aarochu/DirecSun/docs/firmware-design.md

# DirecSun Flight Firmware: Technical Design and Implementation Plan

**Status:** Design for implementation. No firmware has been written, built, flashed, or run. No hardware has been measured. Imported into the repository on 2026-10-10, when the toolchain changed to ESP-IDF v6.0 with C++17; §23.1 rows V-22 onward record every edit made then.
**Parent document:** *DirecSun Technical Design*, `docs/technical-design.md` (referred to below as **TD**). Section numbers such as "TD §6.5" point into that document.
**Related code:** the wire schema in `protocol/schema-v1.json`, the client side of the protocol in `ground/link/`, and the bench console in `ground/console/`. The main UI is `frontend/` (Aaron's), and the backend matches it (§17).
**Audience:** firmware and software engineers, software architects, agentic architects, and AI agents that will write, review, or change the firmware.

---

## 0. How to use this document

- **Humans** should read §1–§4 for orientation, then the section for the module they own. The diagrams are meant to be read on their own.
- **AI agents** should treat §2 (conventions), §15 (message schema), §13 (mode machine), §14 (interlocks), and §21 (agent rules) as binding contracts. Before changing any number, check §23 (validation log) for whether it has already been disputed.
- Every statement that a reader might act on carries a label (§2.1). An unlabelled sentence is explanation, not a fact to rely on.
- Where this document and TD disagree, §23 records the disagreement, the reasoning, and the resolution chosen here. If a later TD revision resolves it differently, TD wins and this document has a bug.

---

## 1. Purpose, scope, and non-goals

### 1.1 Purpose

Specify the firmware for the Seeed XIAO ESP32-S3 on the DirecSun box. It must:

1. read the inertial, magnetic, optical, wheel-speed, and battery sensors;
2. estimate box heading and rate;
3. run the four-loop control cascade and drive the ESC over DShot;
4. implement the eight operating modes and every safety interlock;
5. serve telemetry and accept commands over a WebSocket on the private Wi-Fi network.

It also gives an ordered implementation plan, a test strategy, and the gates that must pass before the wheel is spun.

### 1.2 Scope

In scope: everything that runs on the XIAO ESP32-S3; the wire protocol it speaks; build and test tooling for that code; the integration contract with the main UI in `frontend/`.

### 1.3 Non-goals

- Multi-axis control, orbit dynamics, flight qualification (TD §1).
- ESC firmware changes. Flashing Bluejay for bidirectional DShot is an open option (TD §12.3), not part of this plan.
- The ground-station page itself, except where its behaviour constrains the firmware (§15, §17).
- Over-the-air firmware update. Firmware is flashed over USB-C (TD §5.5).

---

## 2. Conventions

### 2.1 Claim labels

This document reuses the TD labels and adds one.

| Label | Meaning | What a reader should do |
| --- | --- | --- |
| **[V]** | Verified in TD against an opened source (TD marks it [V]) | Trust it; re-check if the part changes |
| **[C]** | Calculated here or in TD from stated inputs; the arithmetic is shown or reproducible | Re-run if an input changes |
| **[A]** | Assumed, typical, or drawn from the author's knowledge of a library or API that was **not** checked against its documentation while writing this document | Confirm before relying on it; most become build checks |
| **[M]** | Must be measured on the hardware | Measure, record in TD §12.2 |
| **[D]** | Design decision made in this document | Change only with a reason recorded in §23 |

**Important limitation.** While this document was written, no datasheet, library header, or source page was opened. Every hardware fact labelled [V] here inherits its [V] from TD. Every ESP-IDF API fact is labelled [A] and is checked by the build or a bench test listed in §19.

### 2.2 Units and representation

| Quantity | Internal unit (firmware) | Wire unit (JSON) |
| --- | --- | --- |
| Angle | radians, `float` | degrees |
| Angular rate | rad/s | deg/s (`*_dps`) |
| Wheel speed | rpm, `float` | rpm |
| Torque | N·m | mN·m (`*_mNm`) |
| Voltage | V | V |
| Time | microseconds since boot, `int64_t` (`esp_timer_get_time()`) [A] | milliseconds since boot (`t_ms`) |

All control arithmetic uses `float` (the ESP32-S3 has a single-precision FPU) [A]. Accumulated quantities that grow without bound (heading integral, time) use `double` or are wrapped, see §11.3.

### 2.3 Sign and frame conventions (binding)

Taken from TD §4.1 and TD §6.5. They are restated because a sign error makes the rate loop unstable (TD §12.4, R-1).

| Symbol | Definition |
| --- | --- |
| +z | Up the spin axis |
| +X | The sun-sensor face of the box |
| ψ (psi) | Box heading. **Positive counter-clockwise seen from above** |
| ω (omega_b) | Box rate about +z, positive counter-clockwise |
| τ_cmd | Torque wanted **on the box**, positive counter-clockwise |
| Ω | Wheel speed in its **forward** direction. Always positive, between the low limit and the cap. Every limit and interlock applies to Ω |
| s_w | ±1, the sign of the wheel's spin about +z when running forward. Fixed by motor wiring; found in T-5 |

The table above is the firmware's internal frame. The control law, the estimator, and the sign check of §12.5 are written in it.

> **Wire frame (decided 2026-10-10, finding U-1) [D]:** on the wire, every quantity about the spin axis is **clockwise positive seen from above**, matching the main UI in `frontend/`. There, "rotate right" is +90°, and the dial and 3D model turn clockwise for positive values (§17). The quantities are `psi_deg`, `psi_ref_deg`, `mag_deg`, `sun_deg`, `rate_dps`, `tau_cmd_mNm`, the SLEW `psi_ref_deg`, and the MANUAL `rate_dps`. The firmware converts only in its protocol encode and decode: a value x in the internal frame is -x on the wire, in both directions. Nothing else in the firmware knows the wire frame exists. Raw bench sensor counts (`gyro_raw`, `mag_raw`) are not converted. No client converts.

### 2.4 Naming

- Modes on the wire: `SAFE`, `SPINUP`, `READY`, `DETUMBLE`, `HOLD`, `SLEW`, `SUN_POINT`, `MANUAL` [D]. TD's schema examples use `"HOLD"` and `"SLEW"`; the other spellings are fixed here.
- Manual inputs on the wire: `throttle`, `wheel`, `rate` [D].
- Interlock names on the wire: upper snake case, listed in §14.1 [D].
- C++ namespaces follow the module names in §18.

---

## 3. Sources and precedence

1. Measurements recorded in TD §12.2 (none exist yet).
2. TD, including `cad/stack.py` and `docs/sizing.py`, which TD says win over TD's prose.
3. This document.
4. Ground code: the main UI in `frontend/`, and the bench tools `ground/link/` and `ground/console/`. They must follow 1 to 3 for anything about the device, and `protocol/schema-v1.json` must agree with §15.

For the wire interface (message fields, units, sign, endpoint), the main UI leads: the schema encodes what `frontend/` expects, and §15 and the firmware follow (owner decision 2026-10-10, finding U-3).

---

## 4. System context

### 4.1 Context diagram

```mermaid
flowchart LR
    subgraph BOX["DirecSun box (rotates on two 608 bearings)"]
        direction TB
        PACK["8 x AA NiMH pack<br/>8.8 to 11.2 V"] --> FUSE["10 A fuse"]
        FUSE --> ESC["BLHeli_S ESC"]
        FUSE --> BUCK["5 V buck"]
        FUSE --> DIV["100k / 22k divider"]
        BUCK --> XIAO["XIAO ESP32-S3<br/>(this firmware)"]
        BUCK --> HALL["A1104 Hall switch"]
        XIAO -- "3V3 + I2C 400 kHz" --> IMU["MPU-6050"]
        IMU -- "STEMMA QT" --> MAG["QMC5883P"]
        MAG -- "STEMMA QT" --> BMP["BMP280"]
        SUN["OP550 x 2"] -- "ADC1 D0, D1" --> XIAO
        DIV -- "ADC1 D9" --> XIAO
        HALL -- "D10 falling edge" --> XIAO
        XIAO -- "DShot on D8 (RMT)" --> ESC
        ESC -- "3 phases" --> MOTOR["2212 motor + washer flywheel"]
        MOTOR -. "magnets pass sensor" .-> HALL
    end
    XIAO <-- "Wi-Fi, WebSocket JSON v1" --> AP["Wi-Fi access point, 2.4 GHz<br/>(OM5P-AC, hotspot, or venue)"]
    AP <--> LAPTOP["Laptop browser<br/>ground station"]
```

### 4.2 External interfaces of the firmware

| Interface | Peer | Direction | Defined in |
| --- | --- | --- | --- |
| I2C bus, 400 kHz | MPU-6050 0x68, QMC5883P 0x2C, BMP280 0x77 | read/write | TD §5.3 [V]; §10 |
| ADC1 ch0, ch1 (GPIO1, GPIO2) | OP550 A, B | read | TD §5.4 [V] |
| ADC1 ch7 (GPIO8) | Battery divider | read | TD §5.4 [V] |
| GPIO9 interrupt | A1104 | input | TD §5.4 [V] |
| GPIO7 RMT TX | ESC DShot input | output | TD §5.4 [V] |
| Wi-Fi STA, WebSocket server on port 80 at `/ws` | Main UI (`frontend/`), bench console | bidirectional | TD §7 [V]; §15 |
| USB-C serial | Developer | log output, flashing | TD §5.5 |
| NVS | Flash | parameter storage | TD §6.1 [D in TD] |

GPIO numbering follows the XIAO pin table in TD §5.4: D0 = GPIO1, D1 = GPIO2, D4 = GPIO5 (SDA), D5 = GPIO6 (SCL), D8 = GPIO7, D9 = GPIO8, D10 = GPIO9 [V]. GPIO1 to GPIO10 are ADC1 channels 0 to 9 [V], so GPIO8 is ADC1 channel 7 [C].

---

## 5. Requirements traced to firmware mechanisms

| ID (TD §2) | Requirement | Firmware mechanism | Verified by |
| --- | --- | --- | --- |
| FR-1 | Reaction wheel is the only actuator | Single DShot output; no other actuator code path | Review |
| FR-2 | Eight modes, mode change within 100 ms | Mode machine (§13) runs every 2 ms tick; command queue drained every tick, so a valid command takes effect within one tick plus network latency | T-13, host test HT-7 |
| FR-3 | 50 Hz telemetry, < 100 ms latency | Snapshot every 10th control tick; comms task sends without blocking control (§7.4) | T-11 |
| FR-4 | Untethered | Battery monitor, Wi-Fi only | Review |
| FR-5 | Safe stop | E-stop command, 1 s heartbeat timeout, undervoltage, plus the full interlock table (§14) | T-13 |
| PR-1 | Detumble 1 rev/s to < 5 deg/s in 5 s | `DETUMBLE` mode, rate loop with ω_cmd = 0 | T-15 |
| PR-2 | 90 deg slew in 3 s, ±3 deg | `SLEW` trapezoid 60 deg/s, 120 deg/s² (about 2.0 s of profile) [C] | T-16 |
| PR-3 | Hold ±2 deg | `HOLD`, attitude + rate loop with integral and anti-windup | T-17 |
| PR-4 | Wheel energy < 6 J at cap, < 6.5 J worst case | Ω_ref clamped to the 4000 rpm cap; overspeed trip at 4100 rpm (5.99 J) [C] | Host test HT-5, T-13 |

The PR-1 requirement needs the gyro range to cover at least 360 deg/s, and TD §10.1 says the box can reach about 4.0 rev/s (1440 deg/s) if the wheel stops from the cap [C]. The gyro is therefore configured for ±2000 deg/s (§10.1, finding V-9).

---

## 6. Hardware interface summary for firmware authors

| Item | Value | Label |
| --- | --- | --- |
| MCU | ESP32-S3, dual core | [V] TD §6.1 |
| Framework | ESP-IDF v6.0, C++17 application code, FreeRTOS tasks | [D] 2026-10-10 (TD §6.1; V-22 records the earlier choice) |
| I2C | SDA GPIO5, SCL GPIO6 on port 0, owned by esp-idf-lib `i2cdev`; every device at 400 kHz, fallback 100 kHz. The library defaults (1 MHz for the esp-idf-lib drivers, 100 kHz hard-coded in the QMC5883P driver) are overridden | [V] TD §5.3 to 5.4 for pins and rate; [V] defaults read from the driver source, 2026-10-10 |
| DShot | DShot300 if ESC MCU is 48 MHz ("H" in its name), DShot150 if 24 MHz ("L") | [V] TD §5.2; [M] read in ESC Configurator |
| DShot frame | 11-bit throttle, 1 telemetry bit, 4-bit CRC; 0 = disarm, 1–47 commands, 48–2047 throttle | [V] TD §6.3 |
| Hall | 2 magnets, both south-out → 2 falling edges per wheel turn | [V] TD §4.6 |
| Battery divider | 22/122 = 0.1803; 11.2 V → 2.02 V; 8.8 V → 1.59 V; 9.6 V → 1.73 V | [C] |
| ADC | 12 dB attenuation, usable to about 2.9 V | [V] TD §5.1 |
| Sensors' supply | 3.3 V from XIAO 3V3 | [V] TD §5.3 |

Derived wheel timing (two Hall edges per turn) [C]:

| Wheel speed | Mechanical | Hall edges/s | Edge period | Motor electrical frequency (7 pole pairs, [A] A-6) | Stored energy |
| --- | --- | --- | --- | --- | --- |
| 800 rpm (low limit, [A] A-8) | 13.3 Hz | 26.7 | 37.5 ms | 93 Hz | 0.23 J |
| 2400 rpm (bias) | 40.0 Hz | 80.0 | 12.5 ms | 280 Hz | 2.05 J |
| 4000 rpm (cap) | 66.7 Hz | 133.3 | 7.5 ms | 467 Hz | 5.70 J |
| 4100 rpm (trip) | 68.3 Hz | 136.7 | 7.3 ms | 478 Hz | 5.99 J |

---

## 7. Software architecture

### 7.1 Principles

1. **One authority per fact.** The control task owns all state. Every other context gets copies.
2. **Control never waits on the network.** Communication between cores uses lock-free or very short critical sections; nothing on the control path blocks on Wi-Fi, TCP, JSON, or flash.
3. **Pure core, thin drivers.** Estimation, control, mode logic, interlocks, DShot encoding, and message parsing are pure functions or plain classes with no hardware calls, so they compile and run on a desktop (§19.1).
4. **Fail to zero throttle.** Every fault path ends in DShot 0 (TD §6), either immediately or after the e-stop ramp (§14.3).
5. **The box is the authority on mode** (TD §7.3). The ground never assumes a command succeeded.

### 7.2 Tasks and cores

| Context | Core | Priority (FreeRTOS) | Period | Work | Label |
| --- | --- | --- | --- | --- | --- |
| `control` task | 1 | Highest application priority (e.g. `configMAX_PRIORITIES − 2`) | 2 ms (500 Hz) | Sensor reads, estimator, mode machine, controllers, interlocks, DShot frame, telemetry snapshot | [D]; rate [V] TD §6.2 |
| Tick source | n/a | ISR | 2 ms | `gptimer` alarm ISR gives a task notification to `control` | [D]; API [A] |
| Hall ISR | any (registered from core 1) | ISR, IRAM | per edge | Store `esp_timer_get_time()` in a ring buffer | [D]; API [A] |
| `comms` task | 0 | Above the main task, below the Wi-Fi driver | event-driven + 50 Hz | WebSocket server, JSON encode/decode, ping/pong, client management | [D] |
| Wi-Fi/lwIP | 0 | System | n/a | Provided by ESP-IDF | [A] default core 0 |
| `app_main` | 0 | Default main-task priority | once | Runs the boot sequence (§8), creates the tasks, returns | [D] |
| Task watchdog | system | n/a | 100 ms | Resets the MCU if `control` stops feeding it | [V] TD §6.2 for the 100 ms |

Why a hardware timer instead of `vTaskDelayUntil(2)`: the project runs FreeRTOS at a 1 kHz tick (`CONFIG_FREERTOS_HZ=1000` in `firmware/sdkconfig.defaults`), so `vTaskDelayUntil` could produce a 2 ms period, but its jitter is a full tick. A `gptimer` alarm gives sub-tick jitter [A]. Either works; the timer is the default and `vTaskDelayUntil` is the fallback if the timer API does not build (build check BC-3, §19.3).

### 7.3 Module and data-flow diagram

```mermaid
flowchart TB
    subgraph CORE1["Core 1: control task, 500 Hz"]
        direction TB
        TICK["gptimer ISR<br/>notify every 2 ms"] --> SENSE
        HALLISR["Hall ISR<br/>edge timestamps"] --> SENSE
        SENSE["Drivers: IMU (every tick)<br/>MAG (every 2nd tick)<br/>ADC sun, battery (every 10th)"] --> EST["Estimator<br/>rate, heading, sun angle, wheel speed"]
        EST --> MODE["Mode machine"]
        CMDQ["Command queue<br/>(single producer)"] --> MODE
        MODE --> CTRL["Control cascade<br/>attitude, rate, torque-to-wheel, wheel PI"]
        EST --> CTRL
        CTRL --> SAFE["Interlocks<br/>(may override everything)"]
        EST --> SAFE
        SAFE --> DSHOT["DShot encoder + RMT TX"]
        SAFE --> SNAP["Telemetry snapshot<br/>(every 10th tick)"]
    end
    subgraph CORE0["Core 0: comms task"]
        direction TB
        WS["WebSocket server"] --> PARSE["JSON parse + validate"]
        PARSE --> CMDQ
        SNAP --> ENC["JSON encode tlm, event, ack"]
        ENC --> WS
    end
    DSHOT --> ESCX["ESC"]
    WS <--> NET["Wi-Fi"]
```

### 7.4 Shared state and concurrency

| Channel | Producer → consumer | Mechanism | Rule |
| --- | --- | --- | --- |
| Commands | comms → control | FreeRTOS queue, depth 16, items are a fixed-size `Command` struct; `xQueueSend` with timeout 0 from comms, `xQueueReceive` with timeout 0 in control | Full queue: comms answers `ack ok:false reason:"busy"`. `estop` bypasses the queue through an atomic flag (below) |
| E-stop | comms → control | `std::atomic<bool> estop_requested` | Set by comms on any `estop`; read and cleared by control on the next tick |
| Heartbeat | comms → control | `std::atomic<int64_t> last_heartbeat_us` | Written on every accepted `ping` or `cmd` from the controlling client |
| Telemetry snapshot | control → comms | Double buffer + sequence counter (seqlock) | Control writes the inactive buffer, then flips an atomic index. Comms copies the active buffer and retries if the counter changed during the copy. Control never waits |
| Events and acks | control → comms | FreeRTOS queue, depth 16 | Control posts with timeout 0; if full, the event is dropped and a `dropped_events` counter in telemetry increments |
| Hall edges | ISR → control | Ring buffer of 8 `int64_t` timestamps + atomic write index | ISR writes only; control reads only |

TD §6.2 specifies "a snapshot struct copied under a spinlock". The seqlock above gives the same consistency without control ever spinning on a lock held by core 0 [D, finding V-12]. A `portMUX` spinlock around a ~200-byte `memcpy` is an acceptable simpler alternative, since the copy takes microseconds [A].

---

## 8. Boot and initialization

### 8.1 Sequence

```mermaid
flowchart TD
    A["Power on or reset"] --> B["Configure GPIO7 as RMT TX,<br/>start sending DShot 0 every 2 ms"]
    B --> C["Init serial log, NVS,<br/>load parameters with defaults and range checks"]
    C --> D["I2C init 400 kHz, bus recovery pulses"]
    D --> E{"MPU-6050 WHO_AM_I == 0x68?"}
    E -- no --> F["Fault: IMU_MISSING<br/>stay in SAFE, keep DShot 0,<br/>report over Wi-Fi when up"]
    E -- yes --> G["Configure MPU-6050:<br/>wake, DLPF_CFG=4, gyro ±2000 dps, accel ±4 g"]
    G --> H{"QMC5883P chip ID 0x00 == 0x80?"}
    H -- no --> I["Fault: MAG_MISSING<br/>SAFE; HOLD, SLEW, SUN_POINT refused"]
    H -- yes --> J["Configure QMC5883P continuous 200 Hz"]
    I --> K
    J --> K["BMP280 probe 0x77 then 0x76<br/>(optional, never blocks boot)"]
    K --> L["ADC1 init + calibration scheme"]
    L --> M["Attach Hall ISR on GPIO9, falling edge"]
    M --> N{"At least 1 s of DShot 0 sent?"}
    N -- no --> N
    N -- yes --> O["Start control task on core 1<br/>mode = SAFE"]
    O --> P["Start Wi-Fi STA: DHCP, mDNS direcsun.local<br/>(static IP or SoftAP if configured)<br/>start comms task on core 0"]
    P --> Q["Enable 100 ms task watchdog on control"]
    F --> P
```

### 8.2 Notes and rationale

- **DShot 0 starts first.** The ESC arms only after seeing zero throttle [V] TD §5.2, and TD §6.3 asks for about 1 s of zeros [A] A-22. Sending zeros from the first milliseconds also means that a reset caused by the watchdog stops drive quickly. The ESC itself switches drive off about 0.3 s after pulses stop [V] TD §5.2, so the reset gap is bounded either way.
- **Boot does not wait for Wi-Fi.** The box is safe in `SAFE` without a ground connection; heartbeat rules only apply in active modes (§14.1).
- **Missing magnetometer** is not fatal: `DETUMBLE` needs only the gyro. Modes that need heading (`HOLD`, `SLEW`, `SUN_POINT`) are refused with a reason [D].
- **Gyro bias.** Bias is estimated continuously while the box is in `SAFE` **and** still (§11.1). It is not taken once at boot, because the box may be moving after a watchdog reset [D, finding V-10].

---

## 9. The control tick

### 9.1 Per-tick flow (every 2 ms)

```mermaid
flowchart TD
    T0["Task notified by timer"] --> T1["t = esp_timer_get_time()<br/>record loop start"]
    T1 --> T2["Read MPU-6050 14 bytes from 0x3B<br/>(accel, temp, gyro)"]
    T2 --> T3{"Even tick?"}
    T3 -- yes --> T4["Read QMC5883P status; if DRDY,<br/>read 6 data bytes, add to 20 ms average"]
    T3 -- no --> T5
    T4 --> T5{"Every 10th tick?"}
    T5 -- yes --> T6["Read sun A, sun B, battery ADC<br/>(spread over ticks 0, 3, 6 of each 10)"]
    T5 -- no --> T7
    T6 --> T7["Drain Hall ring buffer;<br/>update wheel speed estimate"]
    T7 --> T8["Estimator update:<br/>rate, heading (mag fused at 50 Hz), sun angle"]
    T8 --> T9["Drain command queue;<br/>check e-stop flag"]
    T9 --> T10["Mode machine step<br/>(guards, transitions, setpoints)"]
    T10 --> T11["Control cascade → throttle request"]
    T11 --> T12["Interlock evaluation<br/>(may force ramp-down or DShot 0)"]
    T12 --> T13["Encode DShot frame, start RMT transmit<br/>(non-blocking)"]
    T13 --> T14{"Every 10th tick?"}
    T14 -- yes --> T15["Write telemetry snapshot"]
    T14 -- no --> T16
    T15 --> T16["loop_us = now − start;<br/>feed watchdog; wait for next notify"]
```

### 9.2 Timing budget (target, to be measured as `loop_us`)

| Step | Estimate | Label |
| --- | --- | --- |
| IMU burst read, 14 bytes at 400 kHz | 0.39 ms (155 bit times) | [C] |
| Magnetometer status + 6 bytes (every 2nd tick) | about 0.25 ms | [C] |
| One ADC read with calibration (at most one per tick) | tens of µs | [A] |
| Estimator + controllers + interlocks (float) | < 50 µs | [A] |
| DShot encode + RMT start | < 20 µs; the 53 µs DShot300 frame is sent by hardware | [A]; frame [V] |
| JSON is **not** on this core | 0 | [D] |
| **Worst tick** | **about 0.75 ms of 2 ms** | [C on A] |

At 100 kHz I2C the IMU read alone is 1.55 ms [C], and an IMU + magnetometer tick would exceed 2 ms, which is why TD §5.3 runs the bus at 400 kHz. Every tick reads the IMU, so there is no tick free for the magnetometer at 100 kHz. If the oscilloscope check in TD §5.3 forces 100 kHz, the control rate falls to 250 Hz (4 ms ticks: IMU 1.55 ms, plus magnetometer status and data on alternate ticks, about 0.8 ms), and the gains in §12.2 are rechecked for the longer step [D, finding V-6].

`loop_us` above 1500 for more than 10 consecutive ticks raises a `LOOP_OVERRUN` warning flag. A tick that is still running when the next notification arrives counts as a missed tick; 25 consecutive missed ticks (50 ms) trip `CONTROL_STALL` before the watchdog fires [D].

---

## 10. Drivers

### 10.1 MPU-6050 (I2C 0x68)

| Register | Address | Value | Why | Label |
| --- | --- | --- | --- | --- |
| PWR_MGMT_1 | 0x6B | 0x01 (wake, PLL with X gyro clock) | Leaves sleep; gyro clock is more stable than the internal oscillator | [A] register map; TD cites the map as [V] |
| SMPLRT_DIV | 0x19 | 0 | 1 kHz output with DLPF enabled | [A] |
| CONFIG | 0x1A | DLPF_CFG = 4 | 20 Hz gyro / 21 Hz accel bandwidth, 8.3 ms gyro delay | [V] TD §6.4 |
| GYRO_CONFIG | 0x1B | FS_SEL = 3 (±2000 deg/s, 16.4 LSB per deg/s) | Box can reach about 1440 deg/s after a stop from the cap | [C] range need; [A] scale |
| ACCEL_CONFIG | 0x1C | AFS_SEL = 1 (±4 g, 8192 LSB/g) | Headroom for imbalance vibration (T-7 target 0.05 g RMS) without clipping on taps | [D]; [A] scale |
| Data | 0x3B..0x48 | 14-byte burst: accel XYZ, temperature, gyro XYZ, big-endian | One transaction per tick | [A] |
| WHO_AM_I | 0x75 | expect 0x68 | Boot check (TD §6.6) | [A] value; TD names the check |

Driver: esp-idf-lib `mpu6050` ^2.1.9 on `i2cdev`, validated alone on the S3 by the owner. Its device clock is set to 400 kHz before the first transaction, overriding the library's 1 MHz default [D]. Whether `mpu6050_get_motion()` issues the single 14-byte burst §9.2 assumes is [A]; if it does not, the driver wrapper reads 0x3B to 0x48 with one register read.

Error handling: an I2C error or a timeout of more than 1 ms marks the sample invalid. 25 consecutive invalid samples (50 ms) trip `IMU_SILENT` [V] TD §6.7 threshold. After three consecutive errors the driver runs bus recovery (nine SCL clock pulses, then STOP) once [A] standard I2C practice.

Axis mapping: the board sits face up, centred on the spin axis (TD §4.8), so sensor +Z is taken as box +z [A]. T-8 confirms by rotating the box counter-clockwise by hand and checking that ω reads positive [M].

### 10.2 QMC5883P (I2C 0x2C)

| Item | Value | Label |
| --- | --- | --- |
| Chip ID | register 0x00 reads 0x80 | [V] TD §5.3 |
| Data | 0x01..0x06, X/Y/Z | [V] TD §5.3; byte order [A], confirm in the QST datasheet |
| Status | 0x09, data-ready bit | [V] register; bit position [A] |
| Control | 0x0A, 0x0B: continuous mode, output data rate 200 Hz, oversampling and range | [V] registers; **bit values [A]: read them from the QST datasheet before writing the driver** |

Driver: the vendored `duruofu/qmc5883p` 0.1.0 in `firmware/components/qmc5883p`, given the i2cdev bus through `i2cdev_get_shared_handle(I2C_NUM_0, ...)` after the first i2cdev transaction has created it [D]. The driver hard-codes a 100 kHz device clock, and its own comments flag its 8 G sensitivity value as uncertain; both are corrected by documented local patches after checking the QST datasheet [A].

Sampling plan (revised from TD, finding V-5): the control loop runs at 500 Hz and the magnetometer at 200 Hz, so 200 Hz is not an integer divisor of the tick rate. The driver polls the status register every 2nd tick (250 Hz). It reads data only when data-ready is set, which yields every new 200 Hz sample once, and averages all new samples in each 20 ms window into one 50 Hz heading measurement [D].

Mounting: the board hangs upside down under the flipped top deck (TD §4.8). Turning a board over is a 180° rotation about a horizontal axis, which flips **Z and one horizontal axis**, not Z alone (finding V-4). Heading uses only the horizontal components, so the horizontal flip matters and the Z flip does not. The driver applies a configurable axis map `mag_axis_map` (default: negate Y and Z, keep X), and T-9 confirms it: rotating the box counter-clockwise must make magnetic heading increase in the same direction as the integrated gyro [M].

### 10.3 BMP280 (I2C 0x77, optional)

Probed at boot at 0x77, then 0x76 [V] TD §5.3. It is read at 1 Hz on a spare tick if present, and reported in telemetry as `t_c` and `p_pa` (§15.3). It never affects control, modes, or boot [V] TD §5.3. If absent, the fields are `null`. Driver: esp-idf-lib `bmp280` ^1.0.7 at 400 kHz.

### 10.4 A1104 Hall sensor and wheel speed

```mermaid
flowchart LR
    E["Falling edge on GPIO9"] --> I["ISR (IRAM):<br/>t = esp_timer_get_time()<br/>ring[w mod 8] = t; w = w + 1"]
    I --> C["Control tick reads new edges"]
    C --> P["Period = t_k − t_(k−1)"]
    P --> R{"Period plausible?<br/>3 ms ≤ p ≤ 200 ms"}
    R -- no --> X["Discard; count glitch"]
    R -- yes --> S["speed_fast = 30 / p (rpm)<br/>speed_safe = median of last 4"]
    S --> ST{"Time since last edge<br/>> 2 × last period?"}
    ST -- yes --> U["Speed upper bound = 30 / elapsed;<br/>use the lower of bound and estimate"]
    ST -- no --> OK["Fresh estimate"]
```

| Item | Value | Label |
| --- | --- | --- |
| Edges per turn | 2 | [V] TD §4.6 |
| Speed from period p (seconds) | Ω = 60 / (2p) = 30 / p rpm | [C] |
| Plausibility window | 3 ms (10,000 rpm) to 200 ms (150 rpm) | [D] |
| Control estimate `speed_fast` | Latest single period | [D], finding V-7 |
| Interlock estimate `speed_safe` | Median of the last 4 periods | [V] TD §6.4 |
| Staleness rule | If no edge for more than 2 × the last period, the true speed is below 30 / elapsed, so the estimate is replaced by that bound | [C] |
| Pull-up | 12 kΩ to 3.3 V, external | [V] TD §5.3; internal pull-up also enabled [D] |

**Why two estimates (finding V-7).** The median of 4 periods spans 50 ms at bias and delays the estimate by roughly 25 ms [C]. In a speed loop aimed at 5 Hz, a 25 ms delay costs about 45° of phase [C], too much for a margin-limited loop. The control loop therefore uses the latest period, and the interlocks use the median, which rejects single bad edges.

### 10.5 ADC: sun sensors and battery

| Channel | GPIO | Rate | Processing | Label |
| --- | --- | --- | --- | --- |
| Sun A | 1 (ADC1 ch0) | 50 Hz | Calibrated mV, 4-sample average | [V] pin; [D] averaging |
| Sun B | 2 (ADC1 ch1) | 50 Hz | Same | n/a |
| Battery | 8 (ADC1 ch7) | 50 Hz | mV / 0.1803, then a 1 s moving average for the undervoltage interlock | [C] ratio |

Use the ESP-IDF `adc_oneshot` driver with `ADC_ATTEN_DB_12` and the `adc_cali` curve-fitting scheme for mV conversion [A]. ADC2 must not be used, because it is unavailable with Wi-Fi on [V] TD §5.4.

### 10.6 DShot output

```mermaid
flowchart LR
    TH["Throttle request 0..2047<br/>(0 = stop, 48..2047 = throttle)"] --> V["v = (throttle shifted left 1) OR telemetry bit 0"]
    V --> CRC["crc = (v XOR v shr 4 XOR v shr 8) AND 0xF"]
    CRC --> F["frame = (v shifted left 4) OR crc<br/>16 bits, MSB first"]
    F --> RMT["RMT bytes encoder:<br/>bit1 = high 75 percent, bit0 = high 37.5 percent"]
    RMT --> PIN["GPIO7"]
```

| Item | DShot300 | DShot150 | Label |
| --- | --- | --- | --- |
| Bit period | 3.333 µs | 6.667 µs | [C] |
| Frame (16 bits) | 53.3 µs | 106.7 µs | [C]; DShot300 value [V] TD §6.2 |
| '1' high time (75 %) | 2.50 µs | 5.00 µs | [A] Betaflight convention |
| '0' high time (37.5 %) | 1.25 µs | 2.50 µs | [A] |
| RMT ticks at 40 MHz resolution | bit 133, '1' 100 high + 33 low, '0' 50 high + 83 low | ×2 | [C] |

Implementation choice [D]: use the ESP-IDF 5.x RMT TX channel with the built-in **bytes encoder** (configurable `bit0`/`bit1` symbols, MSB first) on the 2-byte frame [A]. This avoids a custom encoder and any external DShot library (TD A-18). If the bytes encoder is unavailable, write the 16-symbol encoder TD §6.1 describes.

Test vectors for the host test HT-1 [C, computed]:

| Throttle | Telemetry bit | 12-bit value | CRC | 16-bit frame |
| --- | --- | --- | --- | --- |
| 0 | 0 | 0x000 | 0x0 | `0x0000` |
| 48 | 0 | 0x060 | 0x6 | `0x0606` |
| 1046 | 0 | 0x82C | 0x6 | `0x82C6` |
| 2047 | 0 | 0xFFE | 0xE | `0xFFEE` |

Rules [D]:

- Commands 1–47 (beeps, direction, settings) are **never** sent by flight code. ESC settings, including **Brake on stop = off** (TD §5.2, §10.3), are made in ESC Configurator.
- Throttle values 1–47 from the controller are mapped to 0. The minimum running throttle is the value that holds the low-limit speed, from the T-5/T-18 map.
- One frame per 2 ms tick. That is within BLHeli_S limits [V] TD §6.2. Frames are never skipped, because a gap longer than about 0.3 s stops the motor [V] TD §5.2.

---

## 11. Estimation

### 11.1 Box rate

```
ω̂ = s_gyro · (g_z − b_z)        [rad/s]
```

- `s_gyro` = +1 by default, confirmed in T-8 [M].
- **Bias `b_z`:** updated with a slow exponential average (time constant 5 s) only when all of these hold: mode is `SAFE`, |g_z − b_z| < 2 deg/s, accel magnitude within 0.05 g of 1 g, and the wheel is below 200 rpm or the box is held [D]. The update is frozen otherwise, so a spinning box after an e-stop cannot corrupt the bias (finding V-10).
- **Vibration:** the 20 Hz DLPF passes 25 to 45 % of the 40 Hz bias-speed vibration [V] TD §6.4. A software notch filter is implemented but off by default. When enabled, its centre follows `speed_safe / 60` Hz and it is switched on only if T-7/T-8 show residual vibration in ω̂ [D].

### 11.2 Wheel speed

See §10.4. `Ω̂ = speed_fast` for control, `speed_safe` for interlocks and telemetry.

### 11.3 Heading

Complementary filter (TD §6.4):

```
every tick (Δt = 2 ms):        ψ̂ ← ψ̂ + ω̂ Δt
every 50 Hz magnetometer step:  ψ̂ ← ψ̂ + k · wrap(ψ_mag − ψ̂),   k = Δt_mag / τ = 0.02 s / 2 s = 0.01
```

| Item | Value | Label |
| --- | --- | --- |
| τ | 2 s, tunable in T-9 | [A] TD §6.4 |
| k per 20 ms step | 0.01 | [C] |
| ψ_mag | `atan2` of the calibrated horizontal field, with a sign chosen so that a counter-clockwise turn increases it (axis map, §10.2) | [M] T-9 |
| Calibration | Hard-iron offset (3 values) + soft-iron 2×2 matrix in the horizontal plane, from a 360° rotation; stored in NVS | [A] method; [M] values |
| `wrap()` | maps to (−π, π] | [D] |
| Storage | ψ̂ kept continuous (unwrapped) as `double` for control; wrapped only for display | [D] |
| Reported | `psi_deg` = wrapped ψ̂ in (−180, 180]; `mag_deg` = wrapped ψ_mag | [D] |
| `zero_heading` command | Adds an offset so that ψ̂ reads 0 at the current orientation; offset stored in RAM, not NVS | [D] |

**Aliasing (finding V-5).** TD §6.4 says the motor's magnets rotate at 13 to 67 Hz and that 200 Hz sampling avoids aliasing. The mechanical rotation is 13 to 67 Hz, but a 14-pole rotor and the phase currents produce fields at the electrical frequency, 7 × mechanical = 93 to 467 Hz [C on A-6]. That is above the 100 Hz Nyquist limit of 200 Hz sampling, so components there **can** alias. The firmware still samples at 200 Hz and averages, which attenuates some of it, but the real defences are the 14 cm distance, the QMC5883P's own oversampling filter, the gyro-dominant filter (τ = 2 s), and T-9 at three wheel speeds. If T-9 shows a speed-dependent offset, the fallback is a per-speed heading correction table indexed by Ω̂ [D].

### 11.4 Sun angle

```
d = (A − B) / (A + B)          valid only when A + B > light_threshold
sun_rad = calibration(d)       piecewise-linear table from T-10
```

`sun_valid` is false below the threshold or outside the calibrated range [V] TD §6.4. `SUN_POINT` drops to `READY` after 0.5 s of invalid sun angle [D].

### 11.5 Tilt

Tilt angle = `acos(a_z / |a|)` from the averaged accelerometer (20 ms window). Interlock above 30° [V] TD §6.7. It is evaluated on the averaged vector, so a single vibration spike does not trip it [D].

---

## 12. Control law

### 12.1 Cascade

```mermaid
flowchart LR
    REF["ψ_ref<br/>(Hold capture,<br/>Slew trapezoid)"] --> A["Attitude P<br/>ω_cmd = K_ψ · wrap(ψ_ref − ψ̂)<br/>limit ±90 deg/s"]
    A --> R["Rate PI<br/>τ_cmd = K_ω e + K_i ∫e<br/>limit ±31 mN·m"]
    R --> W["Torque → wheel reference<br/>Ω_ref += −s_w τ_cmd (1/I_w + 1/I_b) Δt<br/>clamp [Ω_low, Ω_cap]"]
    W --> S["Wheel speed PI + feed-forward<br/>throttle = FF(Ω_ref) + PI(Ω_ref − Ω̂)"]
    S --> D["DShot throttle"]
    D --> P(("Plant"))
    P -- "ψ̂ (gyro + mag)" --> A
    P -- "ω̂ (gyro)" --> R
    P -- "Ω̂ (Hall)" --> S
```

`DETUMBLE` bypasses the attitude block (ω_cmd = 0). `READY` also uses ω_cmd = 0 [V] TD §6.6. `SUN_POINT` replaces `wrap(ψ_ref − ψ̂)` with the calibrated sun angle [V] TD §6.5.

### 12.2 Starting gains and limits

All gains are starting points until G2 (plant measured) [V] TD §6.5. Values recomputed here with the current TD plant (I_b = 1.03e-3 kg·m², I_w = 6.50e-5 kg·m²):

| Parameter | Value | Derivation | Label |
| --- | --- | --- | --- |
| K_ψ | 3.1 s⁻¹ | about 0.49 Hz attitude bandwidth (3.1 / 2π) | [C] TD §6.5 |
| ω_cmd limit | ±90 deg/s | TD §6.5 | [V] TD |
| K_ω | **0.0129 N·m·s/rad** | 2π · 2 Hz · I_b with I_b = 1.03e-3. TD §6.5 states 0.011, which equals 2π · 2 · 8.9e-4, the superseded I_b (finding V-1) | [C] |
| K_i (rate) | start at K_ω · 2π · 0.2 Hz = 0.0163 N·m/rad | Integral corner a decade below the 2 Hz rate bandwidth [D] | [C on D] |
| Integral limit | ±3 mN·m equivalent | Covers the planned friction range 1 to 3 mN·m (TD §3.6) without letting the integral command large torque | [D] |
| τ_cmd limit | ±31 mN·m (3 A × 10.38 mN·m/A) | TD §6.5 | [C] |
| Wheel ref slope at the τ limit | 4842 rpm/s, 9.7 rpm per tick | 0.031 × (1/I_w + 1/I_b) × 60/2π | [C] |
| Ω_low | 800 rpm | until T-18 | [A] A-8 |
| Ω_bias | 2400 rpm | midpoint of low limit and cap | [V] TD §3.4 |
| Ω_cap | 4000 rpm | PR-4 | [V] TD |
| Wheel PI bandwidth | start at **2 Hz**, raise toward 5 Hz only after measuring delay | Hall update 80/s at bias; see V-7 | [D] |
| FF(Ω) | Lookup table, throttle versus steady speed, 8 points from T-5/T-18 | TD §6.5 | [M] |

**Bandwidth separation (finding V-8).** In a cascade, each inner loop should be several times faster than the loop around it. The plan above has attitude 0.5 Hz, rate 2 Hz, and wheel 2–5 Hz, so the rate-to-wheel ratio is only 1 to 2.5. If T-5 shows the wheel loop cannot exceed about 3 Hz, lower the rate bandwidth to about 0.7 Hz (K_ω ≈ 0.0045) and K_ψ in proportion, rather than raising wheel gains past their margin [D].

### 12.3 Saturation and anti-windup

- **Rate integral:** conditional integration. Stop integrating when τ_cmd is saturated or Ω_ref is clamped at a limit in the direction that would need more [D].
- **Ω_ref clamp:** when Ω_ref hits Ω_cap or Ω_low, set the flag `MOMENTUM_SATURATED`, freeze the rate integral, and report through telemetry. The box then cannot be driven further in that direction until desaturation (§13.4).
- **Throttle clamp:** 48..2047 while running; 0 only from the safety layer.

### 12.4 Slew profile

Trapezoid in ψ_ref, limited to 60 deg/s and 120 deg/s² [V] TD §6.5. A 90° slew takes 0.5 s accelerating (15°), 1.0 s at 60 deg/s (60°), and 0.5 s decelerating (15°), 2.0 s in all [C], within PR-2's 3 s. The slew ends (`SLEW` → `READY`, per TD §6.6 "slew complete") when |ψ_ref − ψ̂| < 3° and |ω̂| < 5 deg/s for 0.5 s [D]; a timeout of 6 s ends it with the event `SLEW_TIMEOUT` [D].

`SLEW` targets arrive as absolute `psi_ref_deg` (TD §7.3). The firmware moves ψ_ref along the **shortest** wrapped path to the target [D]. A ground station that wants a specific direction for a 180° move must send an intermediate target.

### 12.5 Sign check before closing the loop

TD R-1 notes that a wrong sign in the torque-to-wheel step makes the rate loop unstable. Before T-15:

1. With the box pinned and `bench_mode` on, step Ω_ref from bias to bias + 300 rpm with the attitude and rate loops disabled (bench command `wheel_step`, §15.3). Confirm the wheel follows. The pin stays in for this step.
2. Unpinned, at reduced K_ω (×0.2), push the box counter-clockwise by hand. Log ω̂ and Ω_ref. Correct behaviour: Ω_ref moves so that the reaction opposes the push, and ω̂ decays. Wrong sign: ω̂ grows; the operator hits e-stop.
3. Record s_w in NVS.

---

## 13. Modes

### 13.1 State machine

```mermaid
stateDiagram-v2
    [*] --> BOOT
    BOOT --> SAFE: sensors found and 1 s of DShot 0
    SAFE --> SPINUP: cmd arm, box still under 5 deg/s, battery above 9.6 V, no latched fault
    SPINUP --> READY: wheel within 5 percent of bias for 0.5 s
    SPINUP --> SAFE: cmd disarm or estop, or interlock
    READY --> DETUMBLE: cmd mode DETUMBLE
    READY --> HOLD: cmd mode HOLD, magnetometer OK
    READY --> SLEW: cmd mode SLEW, magnetometer OK
    READY --> SUN_POINT: cmd mode SUN_POINT, sun_valid
    READY --> SPINUP: cmd respin (box held), new wheel start speed
    READY --> MANUAL: cmd mode MANUAL with input, input loop built
    MANUAL --> READY: cmd mode READY
    MANUAL --> SAFE: estop, disarm, or interlock
    DETUMBLE --> READY: cmd mode READY
    HOLD --> READY: cmd mode READY
    SLEW --> READY: slew complete, timeout, or cmd mode READY
    SUN_POINT --> READY: cmd mode READY, or sun invalid 0.5 s
    READY --> SAFE: cmd disarm or estop, or interlock
    DETUMBLE --> SAFE: estop, disarm, or interlock
    HOLD --> SAFE: estop, disarm, or interlock
    SLEW --> SAFE: estop, disarm, or interlock
    SUN_POINT --> SAFE: estop, disarm, or interlock
```

These additions were approved by the owner on 2026-10-10 and written into TD §6.6 and §6.7: the `disarm` command, the 0.5 s dwell before `READY`, the magnetometer and sun guards, and the `READY → SPINUP` "respin" transition used for desaturation and alternate wheel start speeds (§13.4).

### 13.2 Per-mode behaviour

| Mode | Wheel | Controller active | Setpoint | Exits |
| --- | --- | --- | --- | --- |
| `SAFE` | Ramp-down (§14.3) then DShot 0; or DShot 0 at once (hard faults) | None | n/a | `arm` |
| `SPINUP` | Ω_ref ramps toward the start speed (default bias) at 400 rpm/s; wheel PI active | Wheel loop only. Rate and attitude off: the box is pinned or held [V] TD §2 | Ω_target | At target → `READY` |
| `READY` | Wheel loop | Rate loop | ω_cmd = 0 | Mode commands |
| `DETUMBLE` | Wheel loop | Rate loop | ω_cmd = 0 | `mode READY` |
| `HOLD` | Wheel loop | Attitude + rate | ψ_ref = ψ̂ at entry | `mode READY` |
| `SLEW` | Wheel loop | Attitude + rate | Trapezoid to `psi_ref_deg` | complete, timeout, `mode READY` |
| `SUN_POINT` | Wheel loop | Sun error + rate | sun angle → 0 | `mode READY`, invalid sun |
| `MANUAL` | Open-loop throttle (`throttle`), or the wheel loop (`wheel`, `rate`) | `throttle`: none; `wheel`: wheel loop; `rate`: rate loop over the wheel loop | From `cmd:"manual"` (§13.5) | `mode READY`, `disarm`, `estop`, interlock |

`READY` and `DETUMBLE` run the same controller [V] TD §6.6 says `READY` holds box rate at zero. `DETUMBLE` exists as a separate mode so the ground station and the demo script can name it and so its telemetry can be logged distinctly against PR-1 [D].

The firmware cannot sense the lock pin. The `arm` guard therefore requires a still box (|ω̂| < 5 deg/s), and the ground station must ask the operator to confirm the pin is in before it sends `arm` [D, finding V-13].

### 13.3 Spin-up sequence

```mermaid
sequenceDiagram
    participant Op as Operator
    participant GS as Ground station
    participant FW as Firmware
    participant ESC
    Op->>GS: Insert lock pin, press Arm
    GS->>Op: Ask to confirm the lock pin is in
    Op->>GS: Confirm
    GS->>FW: cmd arm (seq n)
    FW->>FW: Check guards: SAFE, still, Vbat > 9.6 V, no latched fault
    alt guards pass
        FW-->>GS: ack seq n ok:true
        FW-->>GS: event mode SPINUP
        loop every 2 ms
            FW->>ESC: DShot FF(Ω_ref) + PI
        end
        FW-->>GS: event mode READY (wheel at bias for 0.5 s)
        GS->>Op: Pull the lock pin
    else a guard fails
        FW-->>GS: ack seq n ok:false reason
    end
```

Below about 800 rpm sensorless commutation is assumed unreliable [A] A-8, so spin-up begins with throttle feed-forward only and closes the wheel PI once the Hall speed exceeds Ω_low [D].

### 13.4 Desaturation and wheel start speed

TD §3.6 (the later of the two decisions) makes the lock pin the desaturation actuator: the operator stops and pins the box, the firmware returns the wheel to its start speed, the pin comes out. TD §10.2 used to describe an automatic momentum dump where the controller turns the box at about 30 deg/s while friction removes the excess. The two conflicted (finding V-2); the owner approved the §3.6 decision on 2026-10-10 and TD §10.2 now follows it. Desaturation is a `respin`:

```mermaid
flowchart TD
    W["Telemetry flag MOMENTUM_NEAR_LIMIT<br/>(Ω within 300 rpm of a limit)"] --> G["Ground station prompts operator:<br/>stop and pin the box"]
    G --> C["Operator confirms pin is in;<br/>GS sends cmd respin {wheel_rpm}"]
    C --> K{"Mode READY and box rate under 5 deg/s?"}
    K -- no --> N["ack ok:false, reason"]
    K -- yes --> S["SPINUP with Ω_target = requested speed<br/>(default bias; 1000 or 3800 for spin demos, TD §3.6)"]
    S --> R["READY when within 5 percent for 0.5 s"]
    R --> P["Prompt: pull the pin"]
```

`respin` accepts start speeds within [Ω_low + 200, Ω_cap − 200] rpm [D]. That covers TD's 1000 and 3800 rpm values.

### 13.5 Manual mode

Approved by the owner on 2026-10-10 [D]; TD §6.6 holds the same contract.

| Item | Rule |
| --- | --- |
| Entry | From `READY` only, with `{"cmd":"mode","mode":"MANUAL","input":"throttle"}` (or `"wheel"`, `"rate"`) from the controlling client. Refused with `reason:"input not available"` while the firmware lacks that input's loop. The inputs are built in the order `throttle`, `wheel`, `rate` (repository Set 3), each usable on its own |
| `throttle` input | `{"cmd":"manual","throttle":n}`, n clamped to [`manual_throttle_min`, `manual_throttle_max`] (§16). The cascade is bypassed; the throttle goes to DShot open loop. The band comes from the T-5 throttle-to-speed map so that it keeps the wheel between Ω_low and Ω_cap [M] |
| `wheel` input | `{"cmd":"manual","wheel_rpm":n}`, n clamped to [Ω_low, Ω_cap]; sets Ω_ref for the wheel PI + FF loop |
| `rate` input | `{"cmd":"manual","rate_dps":n}`, n clamped to ±90 deg/s; sets ω_cmd for the rate loop, which drives Ω_ref |
| Who and how often | Controlling client only; the setpoint must match the active input; at most 20 Hz (a setpoint within 50 ms of the previous accepted one is refused with `reason:"too fast"`). Each accepted setpoint counts as a heartbeat (§14.4) |
| Staleness | If no setpoint is accepted for 250 ms while the heartbeat stays alive, `rate` falls to ω_cmd = 0, so the box stops turning; `throttle` and `wheel` hold their last value, so the wheel holds its speed and the box does not move. The flag `MANUAL_STALE` is set until the next setpoint. The 1 s heartbeat rule (§14.1) still applies |
| Safety | Every interlock stays active. No input can command past Ω_cap or below Ω_low |
| Exit | `mode READY` → `READY`; `disarm` or `estop` → ramp-down → `SAFE`; any interlock → `SAFE` |
| Telemetry | `mode` is `MANUAL` and `manual_input` names the active input (§15.3) |

---

## 14. Safety

### 14.1 Interlocks

Every interlock is evaluated every tick, after the controller, so it can override the controller's output [D].

| Name (wire) | Condition | Action | Latch | Source |
| --- | --- | --- | --- | --- |
| `ESTOP` | `estop` command from any client | Ramp-down → SAFE | Until next `arm` | TD §6.7 |
| `HEARTBEAT_LOST` | In any mode except SAFE, no `ping` or `cmd` (including a `manual` setpoint) from the **controlling client** for 1 s | Ramp-down → SAFE | Until next `arm` | TD §6.7 |
| `OVERSPEED` | `speed_safe` > Ω_cap + 100 rpm (4100) | DShot 0 at once → SAFE | Until reset by `arm` after Ω < bias | TD §6.7 |
| `UNDERSPEED` | `speed_safe` < Ω_low for 200 ms, in any mode except SPINUP and SAFE | DShot 0 at once → SAFE | Until next `arm` | TD §6.7 |
| `BATTERY_LOW` | 1 s average below 8.8 V | DShot 0 at once → SAFE | Until arm guard passes | TD §6.7 |
| `IMU_SILENT` | 25 consecutive invalid IMU reads (50 ms) | DShot 0 at once → SAFE | Until a valid read and `arm` | TD §6.7 |
| `TILT` | Averaged accel more than 30° from vertical | DShot 0 at once → SAFE | Until upright and `arm` | TD §6.7 |
| `CONTROL_STALL` | 25 consecutive missed ticks | DShot 0 → SAFE; if the task is fully stuck, the 100 ms watchdog resets the MCU | Reboot | TD §6.7; [D] for the soft stage |
| `HALL_SILENT` | Throttle above the low-limit FF value for 500 ms with no Hall edge | DShot 0 at once → SAFE | Until next `arm` | [D] new, finding V-11 |
| `MOMENTUM_NEAR_LIMIT` | Ω within 300 rpm of a limit | Warning flag only | n/a | TD §6.7 |

**Why `HALL_SILENT` is added.** Without it, a disconnected Hall sensor makes `speed_safe` go stale. The staleness bound in §10.4 then drives the speed estimate toward zero, so `UNDERSPEED` would trip after 200 ms, which is safe. But during `SPINUP`, where `UNDERSPEED` is exempt, the wheel PI would push throttle up without bound while the real wheel accelerates past the cap with no overspeed detection. `HALL_SILENT` closes that gap (finding V-11).

### 14.2 Interlock evaluation flow

```mermaid
flowchart TD
    S["After controller, before DShot"] --> H{"Hard fault?<br/>OVERSPEED, UNDERSPEED, BATTERY_LOW,<br/>IMU_SILENT, TILT, HALL_SILENT, CONTROL_STALL"}
    H -- yes --> Z["throttle = 0 now<br/>mode = SAFE, latch fault<br/>post event interlock name"]
    H -- no --> E{"ESTOP flag or<br/>HEARTBEAT_LOST?"}
    E -- yes --> RD["Enter ramp-down (if not already)<br/>mode = SAFE, post event"]
    E -- no --> RAMP{"Ramp-down in progress?"}
    RAMP -- yes --> RS["throttle = ramp value"]
    RAMP -- no --> PASS["throttle = controller output"]
    RD --> RS
    Z --> OUT["Encode DShot"]
    RS --> OUT
    PASS --> OUT
```

### 14.3 Ramp-down (e-stop and heartbeat loss)

TD §6.7: ramp the wheel to zero over 5 s, then DShot 0, so the box speeds up gently. Starting at the cap, the box accelerates at about 5 rad/s² during the ramp and ends near 4.0 rev/s [C]. The ramp limits the acceleration; it does not limit the final box speed, which momentum conservation fixes [C].

Implementation [D]:

1. Freeze the controllers. Record throttle_0 = current throttle.
2. Each tick, throttle = throttle_0 × (1 − t / 5 s), open loop, mapped to 0 once below 48.
3. At t = 5 s, or as soon as a hard fault occurs, send DShot 0.

The ramp is **open-loop on throttle**, not closed-loop on Ω_ref, because closed-loop control below the 800 rpm sensorless limit is not trusted [A] A-8, and because the safety path should not depend on the Hall sensor.

After DShot 0, BLHeli_S stays in its run loop for about 8 s with damped light, which likely brakes the wheel [A] TD A-17, measured in T-12. The box rate after an e-stop is therefore a T-12 measurement, not something firmware controls.

### 14.4 Controlling client and heartbeat

- The **controlling client** is the WebSocket client whose `arm` was last accepted [D].
- Only the controlling client's `ping` and `cmd` messages reset the heartbeat [D].
- `estop` is accepted from **every** client, in every state, without arming [V] TD §7.3.
- Commands other than `estop` and `ping` from a non-controlling client are refused with `reason:"not controlling client"` while the box is armed [D].
- If the controlling client disconnects, the heartbeat expires 1 s later and the ramp-down starts. No reconnect resumes motion; the operator must arm again [D], consistent with TD §7.3 and with the frontend's read-only, no-auto-reconnect link (§17).

This makes a read-only viewer, such as the current frontend's device link, harmless: it receives telemetry but can never keep an armed box alive (finding V-15).

### 14.5 Watchdog

The ESP-IDF task watchdog is configured for 100 ms on the control task [V] TD §6.2 for the value; API [A]. The control task feeds it at the end of every tick. On expiry, the panic handler resets the MCU [A]. The boot path sends DShot 0 within milliseconds (§8). Between the hang and the new zero frames, the ESC itself stops drive about 0.3 s after the last frame [V] TD §5.2.

---

## 15. Communications

### 15.1 Network

| Item | Value | Label |
| --- | --- | --- |
| Mode | Wi-Fi station with DHCP, 2.4 GHz | [D] 2026-10-10; TD §7.1 |
| Discovery | mDNS hostname `direcsun` (`espressif/mdns`), so the box answers at `direcsun.local`; the assigned address is also logged on the serial console at connect | [D] |
| Credentials, static address, SoftAP flag | menuconfig, from `firmware/sdkconfig.defaults.local` (gitignored); never in source control and never over the wire | [D] |
| Static address (option) | 10.TE.AM.120 on the OM5P-AC, gateway 10.TE.AM.1, /24 | [V] TD §7.1 |
| Power save | Disabled with `esp_wifi_set_ps(WIFI_PS_NONE)` to keep latency low, as in the DirecSun1 prototype | [A] verified by the owner on an ESP32-C3 |
| Fallback | SoftAP selected in menuconfig at build time (default address 192.168.4.1 [A]); never an automatic switch during a session | [D] TD §7.1 names the fallback; automatic switching is rejected because it would change the box address mid-demo |
| Endpoint | Port 80, path `/ws`, the main UI's default: `ws://direcsun.local/ws`, or `ws://<printed address>/ws`; `ws://192.168.4.1/ws` in SoftAP mode | [D] 2026-10-10 (finding U-2); TD §7.2 |

### 15.2 WebSocket server

| Item | Choice | Label |
| --- | --- | --- |
| Library | ESP-IDF `esp_http_server` with `CONFIG_HTTPD_WS_SUPPORT=y`, URI `/ws` registered as a WebSocket handler on port 80, the main UI's endpoint (finding U-2). Other paths are not served. Outbound frames go through `httpd_queue_work` and `httpd_ws_send_frame_async`, the pattern of the DirecSun1 prototype | [A] verified by the owner on an ESP32-C3; build check BC-4 on the S3 |
| Max clients | 3 | [D] |
| Outbound policy | Telemetry is broadcast to all clients. If a client's send would block (buffer full), that frame is skipped for that client and `tlm_dropped` increments. Acks and events are never skipped | [D] |
| Inbound size limit | 512 bytes per message; larger messages are dropped with `ack ok:false reason:"too large"` | [D] |
| JSON | Encode `tlm` with `snprintf` into a fixed buffer (no heap). Parse commands with cJSON from the `espressif/cjson` registry component (ESP-IDF v6.0 no longer bundles it) | [D]; library [A] |
| Contract check | Every message kind is described by `protocol/schema-v1.json`; host test HT-9 validates encoder output against it | [D] |

### 15.3 Message schema, version 1

All messages are JSON objects with `v`, `type`, and `seq` [V] TD §7.3. `seq` is the sender's own counter. Times are box milliseconds since boot. Units are those in §2.2. Every quantity about the spin axis is clockwise positive on the wire, the frame the main UI uses; the firmware converts from its internal frame only in its protocol layer (§2.3, finding U-1).

#### `tlm`: box → all clients, 50 Hz

| Field | Type | Meaning | Source |
| --- | --- | --- | --- |
| `v` | int | 1 | TD |
| `type` | `"tlm"` | n/a | TD |
| `seq` | int | Box telemetry counter | TD |
| `t_ms` | int | Box time since boot | TD |
| `mode` | string | Wire mode name (§2.4) | TD |
| `manual_input` | string or null | `throttle`, `wheel`, or `rate` in `MANUAL`; null otherwise | [D] |
| `psi_deg` | number | Wrapped heading (−180, 180], clockwise positive (wire frame, §2.3) | TD; wrap [D]; sign [D] U-1 |
| `psi_ref_deg` | number or null | Current reference, clockwise positive (null in SAFE, SPINUP, READY, DETUMBLE) | TD; null rule [D] |
| `rate_dps` | number | ω̂, clockwise positive (the internal ω̂ negated) | TD |
| `mag_deg` | number or null | ψ_mag, clockwise positive (null if magnetometer missing) | TD |
| `sun_deg` | number or null | Calibrated sun angle, clockwise positive | TD |
| `sun_valid` | bool | n/a | TD |
| `wheel_rpm` | number | `speed_safe` | TD |
| `wheel_ref_rpm` | number | Ω_ref | TD |
| `throttle` | int | DShot value sent (0..2047) | TD |
| `tau_cmd_mNm` | number | τ_cmd, clockwise positive (the internal τ_cmd negated) | TD |
| `vbat` | number | 1 s average battery voltage | TD |
| `loop_us` | int | Longest tick in the last 20 ms | TD; "longest" [D] |
| `flags` | string[] | e.g. `MOMENTUM_OK`, `MOMENTUM_NEAR_LIMIT`, `MOMENTUM_SATURATED`, `LOOP_OVERRUN`, `MAG_MISSING`, `MANUAL_STALE`, latched fault names | TD; list [D] |
| `t_c`, `p_pa` | number or null | BMP280, optional | [D] |
| `tlm_dropped`, `dropped_events` | int | Counters | [D] |

Example (values illustrative, not measurements; `vbat` chosen inside the NiMH range, finding V-3):

```json
{"v":1,"type":"tlm","seq":1042,"t_ms":83120,"mode":"HOLD",
 "psi_deg":47.2,"psi_ref_deg":47.0,"rate_dps":0.3,"mag_deg":46.8,
 "sun_deg":null,"sun_valid":false,"wheel_rpm":2504,"wheel_ref_rpm":2510,
 "throttle":412,"tau_cmd_mNm":0.8,"vbat":10.1,"loop_us":740,
 "flags":["MOMENTUM_OK"],"t_c":null,"p_pa":null,"tlm_dropped":0,"dropped_events":0}
```

At about 250 to 300 bytes per frame and 50 frames/s the stream is about 12.5 to 15 kB/s, about 0.1 Mb/s [C], far below the radio's 4 Mb/s default limit [V] TD §7.

#### `cmd`: client → box

| `cmd` | Fields | Accepted in | Effect |
| --- | --- | --- | --- |
| `arm` | none | SAFE | → SPINUP if guards pass; sender becomes the controlling client |
| `disarm` | none | SPINUP, READY, active modes | Ramp-down → SAFE (same as e-stop, without the ESTOP latch) [D] |
| `estop` | none | Any state, any client | Ramp-down → SAFE, ESTOP latch |
| `mode` | `mode`; `psi_ref_deg` (clockwise positive) for SLEW; `input` for MANUAL | READY (and active modes for `READY`) | Transition per §13.1 |
| `manual` | exactly one of `throttle` (int), `wheel_rpm`, `rate_dps` (clockwise positive), matching the active input | MANUAL, controlling client only | New setpoint, clamped and rate-limited per §13.5; counts as heartbeat |
| `respin` | `wheel_rpm` (optional, default bias) | READY | → SPINUP to the new start speed (§13.4) |
| `zero_heading` | none | SAFE, READY | Heading offset (§11.3) |
| `set_params` | `params` object | SAFE only | Validate every key and range; store in NVS; reply with the applied set [D] |
| `wheel_step` | `delta_rpm` (±500 max) | READY, bench flag set | Ω_ref step with the attitude and rate loops suspended until `mode READY` is sent again; for §12.5, T-5 and T-18 [D]; refused unless `bench_mode` is true. Interlocks stay active |

#### `ack`: box → sender

```json
{"v":1,"type":"ack","seq":77,"ok":false,"reason":"wheel not at bias"}
```

`seq` echoes the command's `seq` [V] TD §7.3. Unknown `v`, unknown `type`, unknown `cmd`, a malformed message, or a failed guard → `ok:false` with a reason [V] TD §7.3.

> **Ambiguity resolved (finding V-14).** TD defines `seq` as "the sender's counter" for every message, but the ack example uses the command's `seq` (77). The firmware therefore puts the **echoed command seq** in `seq` for `ack` messages only. Every other box message uses the box's own counter.

#### `ping` / `pong`

Client sends `{"v":1,"type":"ping","seq":79,"t_client_ms":512330}` at 5 Hz [V] TD §7.3. Box replies `{"v":1,"type":"pong","seq":<box seq>,"ping_seq":79,"t_client_ms":512330,"t_ms":83120}` [D field names], which lets the client compute round-trip time for T-11.

#### `event`: box → all clients

```json
{"v":1,"type":"event","seq":311,"t_ms":83500,"event":"mode","mode":"SAFE","cause":"HEARTBEAT_LOST"}
```

Sent on every mode change and every interlock trip [V] TD §7.3. `cause` is an interlock name, a command name, or `"slew_complete"` [D].

### 15.4 Command handling sequence

```mermaid
sequenceDiagram
    participant C as Client
    participant CM as comms task (core 0)
    participant Q as Command queue
    participant CT as control task (core 1)
    C->>CM: cmd mode SLEW, psi_ref_deg 137, seq 77
    CM->>CM: Size check, JSON parse, schema check
    alt cmd is estop
        CM->>CT: set atomic estop flag
    else valid
        CM->>Q: push Command{SLEW, 137.0, seq 77, client id}
    else invalid
        CM-->>C: ack seq 77 ok:false reason
    end
    CT->>Q: drain at next tick (≤ 2 ms)
    CT->>CT: guard check in mode machine
    CT->>CM: post ack(77, ok/reason) and event(mode)
    CM-->>C: ack seq 77
    CM-->>C: event mode SLEW (broadcast)
    Note over C: UI shows the mode from tlm/event, never from the button press
```

---

## 16. Parameters and persistence

Stored in NVS under namespace `direcsun` with a `param_version` key. On a version mismatch, defaults are loaded and the event `PARAMS_RESET` is posted [D].

| Key | Default | Range | Set by |
| --- | --- | --- | --- |
| `k_psi` | 3.1 | 0..10 | `set_params` |
| `k_omega` | 0.0129 | 0..0.05 | `set_params` |
| `k_i` | 0.0163 | 0..0.1 | `set_params` |
| `wheel_kp`, `wheel_ki` | from T-5 | ≥ 0 | `set_params` |
| `ff_table` | 8 points | monotonic | `set_params` |
| `omega_low_rpm` | 800 | 500..1500 | after T-18 |
| `omega_bias_rpm` | 2400 | low+400 .. cap−400 | after T-18 |
| `omega_cap_rpm` | 4000 | **≤ 4000, cannot be raised over the wire** | firmware rebuild only (TD §10.3: changing the cap requires re-running Section 3) |
| `s_w`, `s_gyro` | +1 | ±1 | after T-5, T-8 |
| `mag_axis_map`, `mag_cal` | see §10.2 | n/a | after T-9 |
| `sun_cal`, `light_threshold` | identity, 0 | n/a | after T-10 |
| `dshot_rate` | 150 | 150 or 300 | after reading the ESC MCU (TD §5.2) |
| `bench_mode` | false | bool | `set_params` in SAFE |
| `manual_throttle_min`, `manual_throttle_max` | from T-5 [M] | 48..2047, min < max; the band must keep the wheel between Ω_low and Ω_cap | `set_params` in SAFE |
| Wi-Fi SSID, password, static address, SoftAP flag | n/a | n/a | menuconfig, from `firmware/sdkconfig.defaults.local` (gitignored); never over the wire |

`dshot_rate` defaults to the slower, always-supported DShot150 until the ESC's MCU is read [D]. TD says DShot150 works on 24 MHz MCUs and DShot300 needs 48 MHz [V].

---

## 17. Integration with the main UI

The main UI is `frontend/`, Aaron's landing page and ground station, built with React, Vite, and TypeScript. It became the main UI on 2026-10-10 when PR #1 merged, and the owner decided that the backend matches it (finding U-3). For the wire interface (message fields, units, sign, endpoint) the UI leads. `protocol/schema-v1.json` encodes what the UI expects, and §15 and the firmware follow.

`ground/link/` and `ground/console/` are engineering bench tools for firmware bring-up and characterisation, and are not shown to judges. When the UI starts sending commands, its own TypeScript client must keep the safety rules `ground/link/` proves: a 5 Hz ping heartbeat, acks matched to commands by `seq`, an `estop` that is sent at once and never queued, and no automatic reconnect (§14.4, §21).

The table records facts read from the `frontend/` source at PR #1 head 622150a (`src/hardware/deviceLink.ts`, `src/ground/*`, `src/simulation/*`, `src/data/assets.ts`) [V at that commit].

| Main UI fact | Firmware consequence |
| --- | --- |
| The device link (`DeviceLink`, Device link panel) is read-only. It opens a WebSocket and never sends | The UI cannot arm or e-stop the box yet. A read-only viewer is harmless, because it can never keep an armed box alive (§14.4). The operator commands it will send are implemented when the UI defines them (repository Set 4, R4.1) |
| `parseTelemetry` accepts `type:"tlm"` with `v` 1 or absent and requires a finite numeric `psi_deg`; anything else is counted as "ignored" | The firmware's `tlm` always carries numeric `psi_deg` (§15.3). Every non-`tlm` frame the box broadcasts (`event`, and `ack` or `pong` if the UI ever sends) is counted as ignored and shown in the panel's status line |
| It reads `seq`, `t_ms`, `mode`, `psi_deg`, `psi_ref_deg`, `rate_dps`, `wheel_rpm`, `vbat`. It unwraps successive `psi_deg` values into a continuous heading, takes `psi_ref_deg` relative to the heading (null means "target = heading"), uses `t_ms` as its time base, and shows `mode` verbatim | All present in §15.3. `t_ms` must be monotonic, which it is (time since boot). The battery row appears only when `vbat` is numeric |
| It does not reconnect automatically | Matches §14.4 |
| Its endpoint placeholder is `ws://192.168.4.1/ws`, and it saves whatever URL the user enters | The firmware serves port 80 at `/ws` (§15.1, §15.2): SoftAP mode is exactly that default, and station mode is `ws://direcsun.local/ws` (finding U-2) |
| **Positive heading is clockwise seen from above.** "Rotate right" commands +90°, the dial's needle is drawn at (sin ψ, -cos ψ) in screen coordinates, and the 3D model turns by `rotation.y = -ψ` | The wire is clockwise positive and the firmware converts in its protocol layer (§2.3, finding U-1). A box turning clockwise by hand must turn the UI's dial clockwise |
| Its judge sequence turns 90° left or right, holds 1.0 s, and returns to the start heading, at 60 deg/s and 120 deg/s² (`src/simulation/constants.ts`), with Stop and Reset | The same trapezoid limits as §12.4. On hardware it needs HOLD and SLEW. Whether the UI sends a pair of `SLEW` commands or one sequence command is decided by what the finished UI sends (repository Set 4) |
| It loads `/assets/direcsun.glb` when present, and otherwise draws a schematic box ("SCHEMATIC MODEL, CAD NOT LOADED") | The CAD pipeline exports that model (repository Set 2, R2.5) |
| While device telemetry is live, the simulation controls are locked and the header reads "DEVICE CONNECTED, RECEIVING TELEMETRY" | No firmware consequence |

---

## 18. Repository layout and build

### 18.1 Layout

```text
firmware/                     ESP-IDF v6.0 project; run idf.py from here (or tools/idf.sh)
  CMakeLists.txt              project, C++17, SDKCONFIG_DEFAULTS (+ sdkconfig.defaults.local if present)
  sdkconfig.defaults          tracked, annotated line by line
  sdkconfig.defaults.local    gitignored: Wi-Fi credentials, static address, SoftAP flag
  dependencies.lock           committed, for reproducible builds
  main/
    app_main.cpp              boot sequence (§8), task creation
    control_task.cpp/.hpp     tick orchestration (§9)
    shared.hpp                queues, seqlock snapshot, atomics (§7.4)
    idf_component.yml         esp-idf-lib/mpu6050, esp-idf-lib/bmp280, espressif/mdns, espressif/cjson
  components/
    direcsun_core/            pure logic: no ESP-IDF, FreeRTOS, or driver headers
      include/direcsun/core/  angles, dshot_frame, wheel_speed, estimator, controllers,
                              modes, interlocks, protocol, params (.hpp)
      src/
    direcsun_drivers/         hardware access only: i2c_bus (i2cdev, recovery), imu, mag,
                              baro, hall (ISR + ring buffer), adc_inputs, dshot_rmt
    direcsun_comms/           wifi (STA, DHCP, mDNS, SoftAP), ws_server (esp_http_server),
                              comms task, JSON (cJSON)
    qmc5883p/                 vendored duruofu/qmc5883p 0.1.0 with documented local patches
  test/host/                  CMake + doctest, host compiler, ASan and UBSan
    test_*.cpp                one file per core module (HT-1 to HT-11)
    plant_sim.hpp             two-body plant from TD §3.1 for closed-loop host tests
```

`direcsun_core` must not include any ESP-IDF, FreeRTOS, or driver header. That rule is what makes host testing possible; `tools/check-core-purity.sh` enforces it in CI [D]. C++ code uses the namespace `direcsun` with one nested namespace per module.

### 18.2 Toolchain

| Item | Choice | Label |
| --- | --- | --- |
| SDK | ESP-IDF v6.0 installed with EIM; `tools/idf.sh` activates it and runs `idf.py` in `firmware/` | [D] 2026-10-10 (§24 Q1) |
| Target | `esp32s3` | [V] TD §6.1 |
| Language | C++17 (`gnu++17`), exceptions and RTTI off; the vendored drivers are C | [D] 2026-10-10 |
| Host tests | CMake + doctest (vendored single header) with the host g++ | [D] |

---

## 19. Verification

### 19.1 Host tests (no hardware, run on every change)

| ID | Module | What it proves |
| --- | --- | --- |
| HT-1 | `dshot_frame` | The four vectors in §10.6; values 1–47 never emitted for controller requests |
| HT-2 | `wheel_speed` | 30/p conversion; plausibility window; median; staleness bound falls with time |
| HT-3 | `estimator` | Bias frozen while moving; complementary filter converges to ψ_mag with τ = 2 s; wrap at ±180 |
| HT-4 | `controllers` | Anti-windup stops integration at saturation; trapezoid gives 2.0 s ± 1 tick for 90° |
| HT-5 | `controllers` + `plant_sim` | Closed loop on the TD §3.1 plant: detumble 1 rev/s within 5 s; 90° slew within 3 s settling to ±3°; Ω_ref never exceeds 4000 rpm |
| HT-6 | `controllers` sign | With s_w = −1 instead of +1, HT-5's detumble diverges, so the test can see a sign error (positive control) |
| HT-7 | `modes` | Every row of §13.1, every refused transition with its reason, FR-2 timing in ticks |
| HT-8 | `interlocks` | Each interlock trips at its threshold and not 1 % below; hard faults zero throttle in the same tick; ramp-down reaches 0 at 5 s |
| HT-9 | `protocol` | Parse every `cmd`; reject oversize, wrong `v`, unknown `type`; `ack` echoes `seq`; `tlm` round-trips through a JSON parser |
| HT-10 | `interlocks` | `HALL_SILENT` trips during SPINUP with throttle high and no edges |
| HT-11 | `modes` + `protocol` | `MANUAL`: entry refused from any mode but READY and for an unbuilt input; each setpoint form clamps to its limits; a setpoint for the wrong input, from a non-controlling client, or under 50 ms after the last is refused; after 250 ms without setpoints `rate` falls to 0 and `MANUAL_STALE` is set while `throttle` and `wheel` hold; an accepted setpoint resets the heartbeat |

HT-6 follows TD §8.5's rule that an empty result counts only if a known positive is detected by the same instrument.

### 19.2 Bench and integration tests

These map firmware features onto TD §9:

| TD test | Firmware needed |
| --- | --- |
| T-5 ESC arming, DShot, s_w | §8 boot zeros, §10.6, `bench_mode` + `wheel_step` |
| T-6 Hall vs strobe | §10.4, `wheel_rpm` in telemetry |
| T-7 imbalance | Raw accel RMS field: add `accel_rms_g` to `tlm` when `bench_mode` is true [D] |
| T-8 gyro bias and noise | §11.1; raw gyro in bench telemetry |
| T-9 magnetometer | Raw mag fields in bench telemetry; calibration upload via `set_params` |
| T-10 sun sensor | Raw A, B in bench telemetry |
| T-11 telemetry | `seq`, `t_ms`, `pong` |
| T-12 ESC signal loss | Bench command to stop sending frames is **not** provided; unplug the wire as TD describes [D] |
| T-13 interlocks | Every interlock trips with an `event` naming it |
| T-15–T-17 | Modes and controllers |
| T-18 low-speed limit | `wheel_step` downward in bench mode with UNDERSPEED threshold temporarily lowered via `set_params` (bench mode only) |

### 19.3 Build checks (first day, before any feature work)

| ID | Check | Unblocks |
| --- | --- | --- |
| BC-1 | ESP-IDF v6.0 builds the skeleton (every driver library linked) for esp32s3, and it boots on the XIAO | Everything |
| BC-2 | RMT bytes encoder produces the four §10.6 frames; verify on a logic analyser or oscilloscope at both DShot rates | DShot |
| BC-3 | `gptimer` alarm notifies a task at 500 Hz; log jitter for 10 s | Control timing |
| BC-4 | `esp_http_server` WebSocket on port 80 at `/ws` accepts the main UI, the console, and a test client; 50 Hz broadcast for 10 min | Comms |
| BC-5 | Task watchdog at 100 ms resets the board when the control task is deliberately blocked | Safety |
| BC-6 | I2C at 400 kHz reads all three Adafruit boards on one i2cdev-owned bus, with the QMC5883P on the shared handle; scope the edges (TD §5.3) | Sensors |

---

## 20. Implementation plan

### 20.1 Order of work

```mermaid
flowchart TD
    BC["Build checks BC-1..BC-6"] --> CORE["core/ modules + host tests HT-1..HT-10<br/>(no hardware needed)"]
    BC --> DRV["Drivers: I2C, IMU, MAG, ADC, Hall, DShot"]
    CORE --> INT["Control task skeleton:<br/>tick, sensors, estimator, SAFE only, DShot 0"]
    DRV --> INT
    INT --> COMMS["Comms: tlm, ping/pong, ack, event, estop"]
    COMMS --> G1{"G1 Hardware ready<br/>(TD §11.3): T-5, T-7"}
    G1 --> CHAR["Characterisation T-3..T-10, T-18<br/>with bench_mode"]
    CHAR --> G2{"G2 Plant known:<br/>I_b, friction, low limit;<br/>gains recomputed"}
    G2 --> SIGN["Sign check §12.5"]
    SIGN --> WL["Wheel speed loop, then rate loop,<br/>DETUMBLE"]
    WL --> G3{"G3 Loop closed: T-15"}
    G3 --> AL["Attitude loop, HOLD, SLEW, SUN_POINT, respin"]
    AL --> SAFE["Safety tests T-11..T-14"]
    SAFE --> G4{"G4 Demo ready"}
```

### 20.2 Work items

| ID | Item | Depends on | Done when | Owner (TD §11.5) |
| --- | --- | --- | --- | --- |
| F-1 | Toolchain, BC-1..BC-6 | n/a | All six pass | Julian |
| F-2 | `core/` + host tests | F-1 (compiler only) | HT-1..HT-10 pass | Julian; an agent can draft |
| F-3 | Drivers | F-1, assembled electronics (W-3) | Raw values on serial | Julian |
| F-4 | Control task skeleton, SAFE only | F-2, F-3 | `loop_us` < 1000 for 10 min, DShot 0 verified on scope | Julian |
| F-5 | Comms | F-4 | Frontend shows live telemetry; T-11 passes | Julian; Aaron checks the page |
| F-6 | Bench mode and characterisation support | F-5 | TD §12.2 values recorded | Both |
| F-7 | Wheel loop, rate loop, DETUMBLE | G2 | T-15 | Julian |
| F-8 | Attitude, HOLD, SLEW, SUN_POINT, respin | G3 | T-16, T-17 | Julian |
| F-9 | Interlock verification | F-7 | T-13 | Both |

In `changes/`, F-1 is Set 1 (R1.4, R1.5) and the start of Set 3; F-2 to F-6 are Set 3 (teleop); F-7 and F-9 are Set 4 (detumble); F-8 is Set 5 (pointing).

---

## 21. Rules for AI agents changing this firmware

1. **Never** send DShot commands 1–47 from flight code, and never add a wire command that changes ESC settings.
2. **Never** raise `omega_cap_rpm` above 4000, add a way to raise it over the network, or weaken an interlock threshold, without a TD revision that re-runs TD §3 and PR-4.
3. Keep `direcsun_core` free of hardware headers (`tools/check-core-purity.sh`). If logic needs hardware, add a driver interface and inject it.
4. Every new interlock gets a host test that shows it trips, and a test that shows it does not trip 1 % inside the threshold.
5. A passing test suite counts only if HT-6 (the deliberate sign error) still fails as expected. Do not delete or weaken positive controls.
6. Keep claim labels honest. When a number changes, update §23 with the old value, the new value, and why.
7. Change the wire schema only under the versioning rule in `protocol/README.md`: additive, backward-compatible changes stay `v: 1`, and breaking changes bump `v`. The schema, §15, §17, `ground/link/`, `tools/mock-box.py`, and the firmware encoder change together. For the wire interface the main UI in `frontend/` leads, and the backend matches it.
8. Do not add automatic reconnection, automatic re-arming, or any path that resumes wheel motion without a fresh `arm` from an operator.
9. Follow the git flow in `changes/CONTEXT.md` (TD §8.5).

---

## 22. Firmware-specific risks

| Risk | Effect | Mitigation | Label |
| --- | --- | --- | --- |
| Rate-loop sign error | Box accelerates instead of damping | §12.5 sign check at reduced gain; HT-6 | [C] TD R-1 |
| Hall disconnect during SPINUP | Wheel overspeeds undetected | `HALL_SILENT` interlock | [D] V-11 |
| Magnetometer axis map wrong | Heading mirrored; HOLD drifts or runs away | T-9 direction check; HOLD refused until `mag_cal` is set [D] | [M] |
| Wheel loop too slow for the rate loop | Oscillation in DETUMBLE | Start at 2 Hz wheel; lower rate bandwidth if needed (§12.2) | [C] V-8 |
| Wi-Fi task starves core 0 | Telemetry gaps | Control is on core 1 and never waits; telemetry drops are counted | [A] |
| I2C forced to 100 kHz | Tick overrun | §9.2 fallback plan | [C] |
| ESP-IDF v6.0 API or registry surprises (RMT bytes encoder, `i2c_master`, cJSON and mDNS now registry components) | Delay | Set 1 links every library in the skeleton build; BC-2, BC-4, BC-6 early | [A] |
| NVS corruption or stale params | Wrong gains or signs after reflash | `param_version`, range checks, `PARAMS_RESET` event | [D] |

---

## 23. Adversarial validation log

Each statement below was challenged by recomputing it from TD's inputs, by checking it against another TD section, or by asking what a broken instrument would show. Findings marked **TD** are disagreements with the parent document; findings marked **This doc** are corrections made while drafting this document.

### 23.1 Findings

Rows U-1 onward record the main UI contract (2026-10-10). They are numbered separately, because the V-numbers after V-29 are taken by work on the Set 3 branch.

| # | Statement challenged | Check | Finding | Resolution here | Severity |
| --- | --- | --- | --- | --- | --- |
| V-1 | TD §6.5: K_ω = 2π · 2 Hz · I_b = 0.011 | Recomputed with TD §3.2's I_b = 1.03e-3 | 0.0129. The 0.011 value used the superseded I_b = 8.9e-4 (TD E-3) | Default 0.0129 (§12.2). TD T-3's pass band "within 30 % of 8.9e-4" is also stale; should read 1.03e-3 | Medium (TD) |
| V-2 | TD §10.2: automatic momentum dump at about 30 deg/s | Compared with the later decision in TD §3.6 | Conflicts: §3.6 makes the lock pin the desaturation actuator | `respin` sequence (§13.4); no automatic dump | Medium (TD) |
| V-3 | TD §7.3 example `"vbat":11.6` | NiMH range 8.8 to 11.2 V (TD §5.1) | 11.6 V cannot occur on the 8-cell NiMH pack | Example uses 10.1 V | Low (TD) |
| V-4 | TD §4.8: "the firmware inverts the magnetometer's Z axis" | Geometry: turning a board over is a proper rotation | Inverting Z alone is a reflection; a 180° flip about a horizontal axis negates Z and one horizontal axis. Heading uses the horizontal axes, so a Z-only inversion would leave heading mirrored | Configurable axis map, default negate Y and Z, confirmed by T-9 direction check | High (TD) |
| V-5 | TD §6.4: motor magnets at 13–67 Hz; 200 Hz sampling prevents aliasing | Pole count 14 (TD A-6) | Field components at 7× mechanical = 93–467 Hz exceed the 100 Hz Nyquist limit of 200 Hz sampling, so aliasing is possible. Also, 200 Hz is not an integer divisor of the 500 Hz tick | Poll every 2nd tick for data-ready; rely on distance, sensor oversampling, gyro-dominant filter, and T-9 at three speeds; per-speed correction table as fallback | Medium (TD) |
| V-6 | TD §5.3: at 100 kHz "the 1.5 ms IMU read still fits a 2 ms tick on its own" | 155 bit times at 100 kHz | 1.55 ms: fits only if nothing else is read in that tick, and leaves 0.45 ms for everything else | Explicit 100 kHz fallback plan (§9.2) | Low (TD) |
| V-7 | TD §6.4: wheel speed = median of last four periods, used by the 5–10 Hz wheel loop | Delay of a 4-period median at bias ≈ 25 ms | About 45° phase lag at 5 Hz and 90° at 10 Hz | Separate fast estimate for control, median for interlocks; wheel loop starts at 2 Hz | Medium (TD) |
| V-8 | TD §6.5 bandwidths 0.5 / 2 / 5–10 Hz | Cascade separation rule of thumb (inner ≥ 3–5× outer) | Rate-to-wheel ratio is 1–2.5 at the low end of the wheel target | Lower rate bandwidth if wheel loop < 3 Hz | Medium (This doc, from TD values) |
| V-9 | Gyro full-scale range unspecified in TD | Box can reach 1440 deg/s after a cap stop; PR-1 needs 360 deg/s | ±250 or ±500 deg/s ranges would clip | ±2000 deg/s (FS_SEL 3) | Medium (gap in TD) |
| V-10 | TD §6.4: bias "estimated while the box is still in Safe mode" | Safe mode is also entered after e-stop with the box spinning | Bias must be gated on actual stillness, not on mode | Stillness gate (§11.1) | Medium (TD wording) |
| V-11 | TD §6.7 interlocks with UNDERSPEED exempt during Spin-up | Failure analysis: Hall wire off during Spin-up | Wheel PI drives throttle up; OVERSPEED cannot see it | New `HALL_SILENT` interlock (§14.1) | High (gap in TD) |
| V-12 | TD §6.2: snapshot copied under a spinlock | Control on core 1 could spin while core 0 holds the lock | Bounded but unnecessary | Seqlock double buffer; spinlock acceptable alternative | Low (This doc) |
| V-13 | TD §6.6: arm guard "held by the lock pin or the operator" | Firmware has no pin sensor | Guard cannot be checked by firmware | Stillness check + ground-station confirmation prompt | Medium (TD) |
| V-14 | TD §7.3: `seq` is "sender's counter"; ack example echoes the command seq | Two rules collide for `ack` | Ambiguous | `ack.seq` echoes the command `seq`; all other box messages use the box counter | Low (TD) |
| V-15 | Heartbeat "no command or ping for 1 s" with multiple clients | A read-only viewer or a second page could keep an armed box alive if any traffic counted | Unsafe if not specified | Only the controlling client resets the heartbeat (§14.4) | High (gap in TD) |
| V-16 | Frontend placeholder `ws://192.168.4.1/ws` | TD §7.2 endpoint `ws://10.TE.AM.120:81/` | Wrong port and path for both station and SoftAP modes | Change the placeholder (§17) | Low (frontend) |
| V-17 | Frontend: positive heading = clockwise | TD §6.5: CCW positive | The frontend 3D view would turn opposite to the real box | Convert in the frontend (§17) | High (frontend) |
| V-18 | TD §3.1: "K_t … for 9202KV" | Recomputed 60/(2π·920) = 10.38 mN·m/A | Typo for 920 KV; value correct | None needed in firmware | Low (TD) |
| V-19 | TD §2 opening: "a 0.7 kg box" | TD §3.2: 844 g with wheel | Stale figure | None needed in firmware | Low (TD) |
| V-20 | TD §6.7 e-stop: "ramp the wheel to zero over 5 s, so the box speeds up gently" | Momentum conservation | The ramp limits acceleration (about 5 rad/s² from the cap), not the final box speed (about 4.0 rev/s from the cap) | Stated explicitly (§14.3); open-loop throttle ramp because control below 800 rpm is not trusted | Low (TD wording) |
| V-21 | TD §5.2: "DShot300 if … 48 MHz" | No measurement yet | Choosing DShot300 before reading the ESC risks unreliable frames on a 24 MHz MCU | Default DShot150 until read (§16) | Low (This doc) |
| V-22 | §6, §7.2, §10, §15.2, §18, §19.3, §22 assumed Arduino-ESP32 core 3.x built with PlatformIO or Arduino CLI, arduinoWebSockets, and ArduinoJson | Owner decision 2026-10-10 | The owner chose ESP-IDF v6.0 with C++17 to match the sensor drivers validated on the ESP32-S3 | Rewritten for ESP-IDF: `esp_http_server` WebSocket (verified on an ESP32-C3 in the DirecSun1 prototype), cJSON from `espressif/cjson`, `app_main` replaces `loop()`, layout under `firmware/components`, toolchain in §18.2 | Medium (this doc) |
| V-23 | §15.1: station on the OM5P-AC at static 10.TE.AM.120; credentials in NVS set over USB serial | Owner decision 2026-10-10 | A static address works only on the FRC radio, and any 2.4 GHz access point should do for the demo | Station with DHCP and mDNS `direcsun.local`; static address and SoftAP in menuconfig; credentials from a gitignored `sdkconfig.defaults.local` | Medium (TD and this doc) |
| V-24 | §2.3 and §17 assumed the `direcsun/` frontend would integrate directly and left the sign convention open | Owner decisions 2026-10-10 | The demo UI is Aaron's and lives outside the repository; the wire stays CCW-positive | The UI uses `ground/link/` and converts signs for display; §24 Q4 and Q5 closed | Low |
| V-25 | §13.1 diagram: DETUMBLE, HOLD, SLEW, SUN_POINT left for SAFE only on "estop or interlock" | §15.3 accepts `disarm` in active modes | The diagram omitted `disarm` | Edges now read "estop, disarm, or interlock" | Low (this doc) |
| V-26 | Seven operating modes | Owner decision 2026-10-10 | Teleoperation needed a mode of its own | `MANUAL` added (§13.5) with `manual_input`, `MANUAL_STALE`, `manual_throttle_min/max`, and host test HT-11 | Medium (this doc and TD) |
| V-27 | §24 Q6 additions and the V-1, V-4, V-5, V-7, V-9, V-14 corrections awaited owner approval | Owner review 2026-10-10 | Approved | Written into TD §4.8, §5.2, §6.4 to §6.7, §7.3, §9.1, §10; §13.1 and §13.4 text updated | n/a |
| V-28 | Em dashes in headings and empty table cells | Owner style | n/a | Replaced with colons, "none", or "n/a" | Low |
| V-29 | §10 had no driver notes | Driver source read 2026-10-10 | The esp-idf-lib drivers default to 1 MHz SCL, the QMC5883P driver hard-codes 100 kHz, and the drivers were validated only one at a time | Driver notes in §10.1 to §10.3; 400 kHz override [D]; TD A-23 | Medium (this doc) |
| U-1 | §2.3, §15.3, §17: the wire is counter-clockwise positive and the UI negates for display (V-17, V-24) | Main UI source at PR #1 622150a; owner decision 2026-10-10 | `frontend/` became the main UI, and the backend matches it. The UI draws positive heading clockwise ("rotate right" = +90°, dial at (sin ψ, -cos ψ), model `rotation.y = -ψ`) | The wire is clockwise positive for every quantity about the spin axis, including `tau_cmd_mNm`, which the spec list did not name but which is a torque about the same axis. The firmware converts only in its protocol encode and decode; the internal frame of §2.3 is unchanged. A v1 correction, not a v2 break: no backend had emitted v1, and the only consumer already assumed clockwise. Supersedes V-17 and the sign half of V-24 | High (wire contract) |
| U-2 | §15.1, §15.2, §17, §19.3: WebSocket on port 81 at `/` (V-16 asked the UI to change its placeholder) | Main UI placeholder `ws://192.168.4.1/ws`; owner decision 2026-10-10 | The backend matches the UI | Port 80 at `/ws`: `ws://direcsun.local/ws` in station mode, `ws://192.168.4.1/ws` in SoftAP mode. `ground/link/` default, console hints, and `tools/mock-box.py` (serves only `/ws`, 404 elsewhere) follow. Supersedes V-16 | Medium (wire contract) |
| U-3 | Header, §3, §17, §24 Q4: the demo UI is Aaron's, lives outside the repository, and talks through `ground/link/` | PR #1 merged 2026-10-10 (7136f6a) | `frontend/` is in the repository and is the main UI; it owns its operator client | §17 rewritten as the integration contract with `frontend/`, from its source. `ground/link/` and `ground/console/` are bench tools. §3 says the UI leads the wire interface | Medium |
| U-4 | §21 rule 7: any schema change bumps `v` | Owner decision 2026-10-10 (CONTEXT.md) | Additive changes need not break the UI | Additive, backward-compatible changes stay `v: 1`; breaking changes bump `v` (`protocol/README.md`) | Low |

### 23.2 Statements re-derived and confirmed

All [C], recomputed from TD §3.2 inputs while writing this document. On 2026-10-10 the TD-value column was updated to the regenerated `docs/sizing_output.txt` (TD §12.4, I-17); the Recomputed column is the original derivation from the rounded inputs (I_b = 1.03e-3) and is left as it was, so small differences in the last digit are expected:

| Quantity | TD value | Recomputed |
| --- | --- | --- |
| K_t | 10.38 mN·m/A | 10.380 |
| Box rate per 1000 rpm of wheel change | 355 deg/s | 356.2 |
| Box acceleration at 1 A | 576 deg/s² | 577.4 |
| 90° bang-bang slew at 1 A | 0.79 s, 228 deg/s peak, 640 rpm swing | 0.790 s, 228.0 deg/s, 640 rpm |
| Stored energy at 4000 / 4100 rpm | 5.7 / 5.99 J | 5.70 / 5.99 |
| Box spin if the wheel stops from bias / cap | about 2.4 / 4.0 rev/s | 2.37 / 3.96 |
| Board load at 35 mm, 4.0 rev/s | 2.2 g | 2.21 |
| Battery divider at 11.2 V | 2.02 V | 2.020 |
| Telemetry bandwidth | about 0.1 Mb/s | 0.100 |
| DShot300 frame | 53 µs | 53.3 |
| 14-byte read at 400 / 100 kHz | 0.4 / 1.5 ms | 0.39 / 1.55 |
| Friction margin time, 1600 rpm, 0.1–3 mN·m | 109 / 36 / 11 / 4 s | 108.9 / 36.3 / 10.9 / 3.6 |
| Attitude bandwidth from K_ψ = 3.1 | about 0.5 Hz | 0.49 |

### 23.3 Known limits of this validation

- No datasheet, library header, or source page was opened while writing this document. Register addresses and values for the MPU-6050 beyond those TD quotes, the QMC5883P control bits, and every ESP-IDF API name are [A] and are covered by build checks BC-1..BC-6 or driver bring-up.
- Nothing has been built or measured. Every gain is a starting point.
- The closed-loop host test (HT-5) uses the idealised TD §3.1 plant. It can find sign and logic errors; it cannot predict ESC dynamics, friction, or vibration.

---

## 24. Open questions

1. ~~Toolchain~~: closed 2026-10-10, ESP-IDF v6.0 with C++17 (§18.2).
2. Team number for the 10.TE.AM addressing: needed only if the OM5P-AC static-address option is used (§15.1).
3. ESC MCU type (H or L) → DShot rate. (TD §5.2)
4. ~~Controlling ground station~~: closed 2026-10-10. The main UI in `frontend/` owns its operator client and becomes the controlling client once it sends commands; `ground/link/` is the bench client (§17, finding U-3).
5. ~~Sign convention~~: closed 2026-10-10, revised the same day (finding U-1). The wire follows the main UI and is clockwise positive; the firmware converts in its protocol layer (§2.3).
6. ~~Owner approval of the additions~~: closed 2026-10-10. `disarm`, the READY dwell, the magnetometer and sun guards, `respin`, `HALL_SILENT`, and the controlling-client heartbeat are approved and written into TD §6.6 and §6.7.

---

## 25. Glossary

| Term | Meaning |
| --- | --- |
| Bias speed | Wheel idle speed (2400 rpm) between the low limit and the cap; the wheel never reverses (TD §3.4) |
| Controlling client | The WebSocket client whose `arm` was last accepted (§14.4) |
| DShot | Digital ESC protocol: 16-bit frames of throttle, telemetry bit, and CRC |
| Hard fault | An interlock that zeroes throttle in the same tick (§14.1) |
| Manual mode | Operator control of the wheel from the ground station through one input: throttle, wheel speed, or box rate (§13.5) |
| Ramp-down | 5 s open-loop throttle ramp to zero after e-stop or heartbeat loss (§14.3) |
| Respin | Changing the wheel's start speed with the box pinned; used for desaturation (§13.4) |
| Seqlock | Double-buffered snapshot with a sequence counter; the reader retries if the writer changed it mid-copy |
| s_w | Sign of the wheel's spin about +z when running forward |
| ψ, ω, Ω | Box heading, box rate, wheel speed (§2.3) |
