aarochu/DirecSun/testresults/2026-10-11-ui-display-lag/6-backpressure-spec-on-main.txt

Running 1 test using 1 worker

  ✘  1 e2e/zz-backpressure-probe.spec.ts:3:1 › slow rendering displays recent telemetry instead of building a frame backlog (26.7s)

  1) e2e/zz-backpressure-probe.spec.ts:3:1 › slow rendering displays recent telemetry instead of building a frame backlog 

    Error: expect(received).toBeLessThanOrEqual(expected)

    Expected: <= 10
    Received:    791

      37 |     const packets = Number(displayed?.match(/(\d+) PACKETS/)?.[1]);
      38 |     expect(packets).toBeGreaterThan(0);
    > 39 |     expect(sent - packets).toBeLessThanOrEqual(10);
         |                            ^
      40 |     expect(readMs).toBeLessThan(200);
      41 |   }
      42 | });
        at /tmp/claude-1000/-home-jazoe-projects-DirecSun/2cd541dd-44e4-4126-8e9d-aa31a633f95f/scratchpad/wt/main/frontend/ground-station/e2e/zz-backpressure-probe.spec.ts:39:28

    Error Context: test-results/zz-backpressure-probe-slow-167c5-of-building-a-frame-backlog/error-context.md

  1 failed
    e2e/zz-backpressure-probe.spec.ts:3:1 › slow rendering displays recent telemetry instead of building a frame backlog
