aarochu/DirecSun/docs/hardware/perfboards.html

DirecSun avionics · perfboard build sheet

# DirecSun Perfboards

Hole-by-hole placement for the two boards in cad/README.md: the XIAO carrier, a 50 × 35 mm piece cut from a 5 × 7 cm board to fit the avionics deck's short guides, and the power deck, a full 5 × 7 cm board. Pins follow TD §5.4 and the firmware. Columns are numbered 1 to 18 from the left and rows lettered from the top, as seen from the component side with the XIAO's USB-C at the top edge. Tap any hole, wire or part to see what it is, or tap a net to highlight it.

XIAO carrier · 50 × 35 Power deck · 5 × 7

Component side Solder side (flipped)

Out of date. This is the old plan; your MPM3610 is already at K8 to K11 and the board is being redrawn around it. Do not solder from this view.

Tap a hole, wire or part to see what it is.

### Changed from the CAD plan

- Cut the carrier from a 5 × 7 cm board: keep one original 50 mm edge (the USB-C end, row A) and score between rows L and M, about 35 mm down. Dry-fit it in the avionics deck's guides before soldering.
- The battery divider sits on the power deck, not the carrier, so no 10 V wire reaches the XIAO. Only the divided tap (about 1.8 V) goes up the cable.
- One 4-wire cable joins the decks: battery tap, GND, 5 V and the ESC signal. It is soldered to the power deck and plugs onto J3 on the carrier, so the carrier needs only your 7 header pins.
- Move the two divider resistors from the breadboard as they are. The firmware is calibrated to their ratio (1.761 V at 10.01 V). If you use different ones, measure the tap against a known supply and send me both numbers.

### Needed for the demo

- Carrier: XIAO, Hall header and pull-up, ESC header and series resistor, I²C header, and the VBAT and GND pins to the power deck.
- Power deck: the MPM3610 (already in), the input pads with the inline fuse, both buses, C1, the ESC pads, the divider, and the 4-wire cable to the carrier.
- Optional, dashed on the board: the sun sensor parts (J5, J6, R3, R4).

### Which wire, and how to lay a bus

- The two power buses (power deck rows M and S): your 18 AWG stranded, stripped bare, strands twisted tight and tinned along the whole length so it turns into a stiff bar. Everything else: the 22 AWG solid, bare for straight runs, with its insulation left on wherever it runs near another wire.
- Solder the parts first and clip their leads to about 2 mm on the solder side.
- Put a little solder on every pad that has a dot on the bus. Lay the tinned bar flat along the row, against the clipped leads, and hold it with tape or a clip.
- Reflow the two end dots first, then each dot in between, feeding a little solder until it wraps the bar, the pad, and the lead together.
- Lap the thick ESC and battery leads onto the bar at their pads: tin the lead, lay it along the bar, and heat both.

### How to read the drawing

Wire. Solder only where there is a white-ringed dot. It passes over every other hole without touching it.

Solder bridge. One blob joining exactly the two pads inside the outline, no wire. Marked B.

Bus. Bare 18 AWG laid along the row, soldered at each dot.

Insulated wire. Crosses another wire; solder only at its two end dots.

- Standing resistors: the body sits on the hole with the circle, and the lead bends over to the other hole.
- The solder side view is mirrored left to right, exactly as the board looks when you turn it over. Hole names stay the same.
- Hole names count column 1 from the left and row A from the top, component side up, as drawn. If your board's printed numbers run the other way, go by the drawing, not the print.

## Parts

Ref | Part | Holes | Notes | Demo

## Connections

After soldering, beep every row with the meter: each listed hole must beep to the others in its row, and to nothing in another row.

Net | Joins | Wires

## Cables between the decks

Every cable unplugs at the carrier, so the stack can still come apart. Thread the Hall cable and the J7 cable up through each deck's wire slot as you slide the decks down the rods (motor, power, battery, avionics, top), and plug them into the carrier last. Signal cables use the −Y slots, next to the carrier's headers. Motor phases and supply leads use the +Y slots and stay twisted, away from the signals and from the magnetometer on the top deck (TD §5.5). Lengths are estimates from the deck heights in cad/stack.py.

Cable | From | To | Wires | Route | Length | Demo
Power deck link | Power deck W1 (soldered) | Carrier J3 | VBAT to F16, GND to G16, 5V to H16, ESC to I16; female ends on the carrier side; twist the four together | −Y slots, through the battery deck | 15 to 20 cm | Needed
ESC signal | The ESC's thin signal pair | Power deck W2, W3 | Signal wire into P6, its ground wire into S12 | Same deck | ESC lead | Needed
Hall | Carrier J1 | A1104 on the motor deck bracket | 5V, GND, OUT, twisted | −Y slots, through the battery and power decks | 25 to 30 cm | Needed
I²C to the IMU | Carrier J4 | MPU-6050, either STEMMA QT port | STEMMA QT to header cable | Same deck | as supplied | Needed
I²C up | MPU-6050, other port | QMC5883P on the top deck | STEMMA QT cable | Straight up | 200 mm | Needed
I²C across | QMC5883P | BMP280 | STEMMA QT cable | Top deck | short | Needed
Motor phases | ESC | Motor | Three phase wires, twisted | +Y slot, down to the motor deck | ESC leads | Needed
Battery | Battery box cap A: + from column 1 bottom, − from column 4 bottom | Power deck P1 (M17), P2 (S17) | + through the 10 A inline fuse; twist the pair | Cap A side notches, then the +Y slot down one deck | about 10 cm | Needed
Bench supply | Supply + (through the fuse) and − | Power deck P1, P2 | Instead of the battery, never both at once | +Y slot | as needed | Bench
USB-C | Laptop | XIAO | Powers the avionics for the demo | −Y edge, with a service loop | as needed | Needed
Sun sensors | Carrier J5, J6 | OP550 block on the +X edge | A, B, 3V3 | Same deck | short | Optional

## Battery box wiring

From cad/README.md. Eight AA cells, two rows of four, alternating direction: follow the + and − marks on the holder's top face for the top row; in every column the bottom cell points the other way. Each contact is an M3 screw; outside the cap, stack a washer, the wire loop, a washer, and the nut. Leave slack in every bridge wire so it does not hold the spring. Both caps are drawn as you see them from outside.

1. Cap B: four bridge wires, each joining the top and bottom contact of one column.
2. Cap A: three bridge wires: top row columns 1 to 2, bottom row columns 2 to 3, top row columns 3 to 4. Columns count from the −Y side of the box (cap A faces −X), so from outside cap A column 1 is on your right.
3. Leads: + from cap A column 1 bottom, − from cap A column 4 bottom. Both leave through cap A's side notches and drop through the battery deck's +Y wire slot to the power deck.
4. Put the 10 A fuse (Bussmann AGC-10 in its inline holder, TD §5.1) on the + lead, then solder it to P1 (M17, PACK IN +) and the − lead to P2 (S17, PACK IN −). Twist the pair.
5. Before connecting: measure the pack at the two leads. About 10 to 11 V with charged cells. About 2.5 V low means one cell is in backwards. The firmware also refuses to arm below 9.6 V.
6. With the pack connected and nothing plugged into the carrier, measure 5 V between the MPM3610's 5V pin (K9) and GND (K8). Anything else: stop and tell me.
7. Battery or bench supply into P1 and P2, never both at once. To charge, take off cap B (three M2 screws) and slide the cells out.

## Before you power it

1. The drawing shows the XIAO from above with USB-C at the top edge, so 5V, GND and 3V3 are the top three pins on the right: holes B12, C12 and D12. Before soldering, confirm those three pins on the XIAO you have been using on the breadboard.
2. Diode D1: the stripe (cathode) goes in B15, at the top, toward the 5 V row. Capacitor C1: the stripe (minus) goes on the GND bus.
3. With nothing plugged in, beep 5V to GND, 3V3 to GND, and PACK + to GND. None of them may beep. Then beep each row of the Connections table.
4. Watch the tight spots: D14 and E14 (R1's two holes, 3V3 and Hall OUT), and the two bridges G16 to G17 (GND) and H15 to H16 (5V IN), one row apart. A solder blob there joins two nets.
5. The GND wire between the boards is required even without the buck. Without it the battery reading floats, like the 0.756 V we chased earlier.
6. First power: USB only, no bench supply. Then tell me, and I'll reboot the box and check every sensor in its log before anything spins.
