aarochu/DirecSun/cad/out/battery_cap_a_preview.png

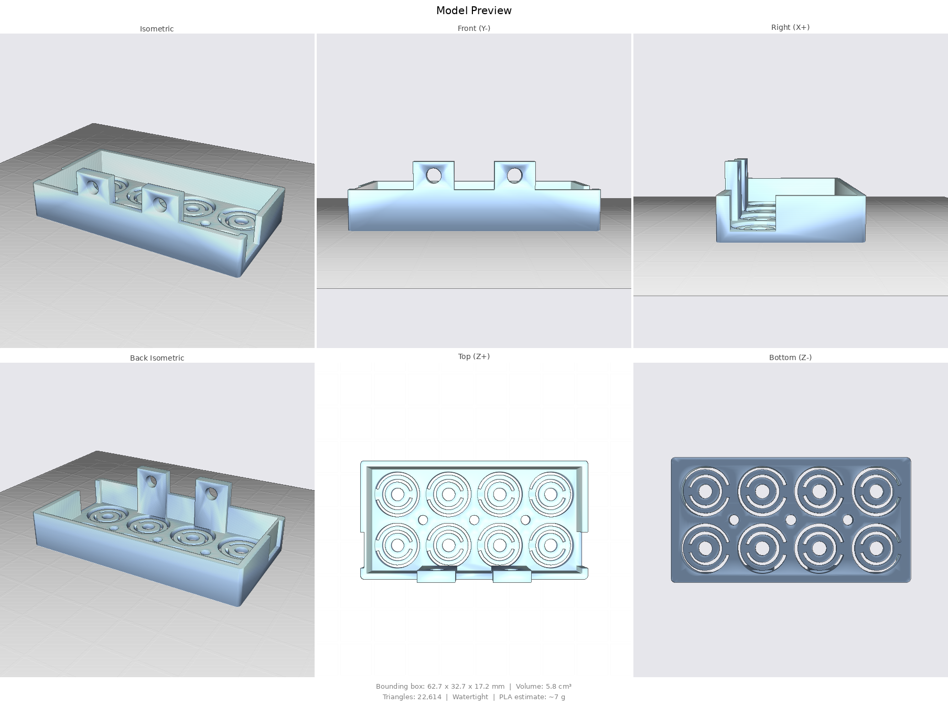
cad/out/battery_cap_a_preview.png
