aarochu/DirecSun/cad/out/battery_deck_preview.png

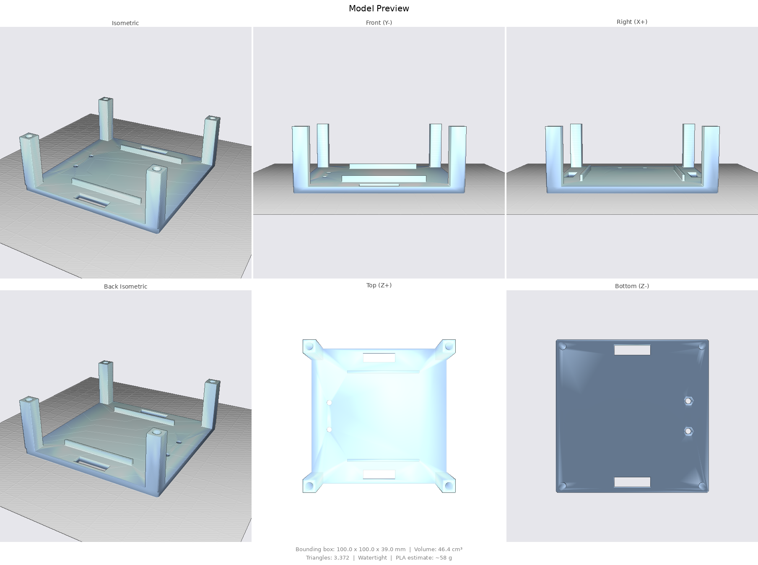
cad/out/battery_deck_preview.png
