aarochu/DirecSun/cad/out/hole_gauge_preview.png

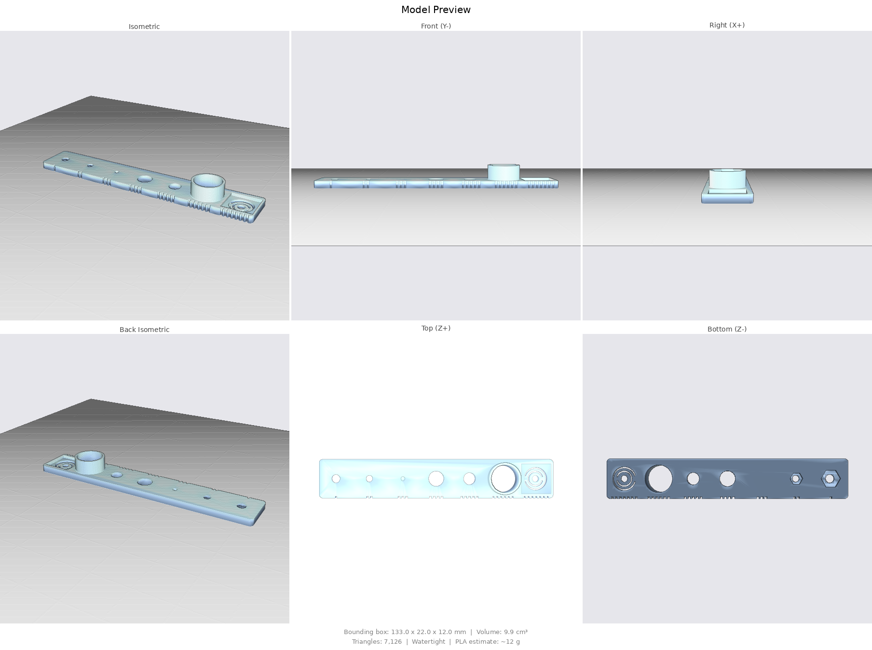
cad/out/hole_gauge_preview.png
