aarochu/DirecSun/cad/out/hole_ladder_preview.png

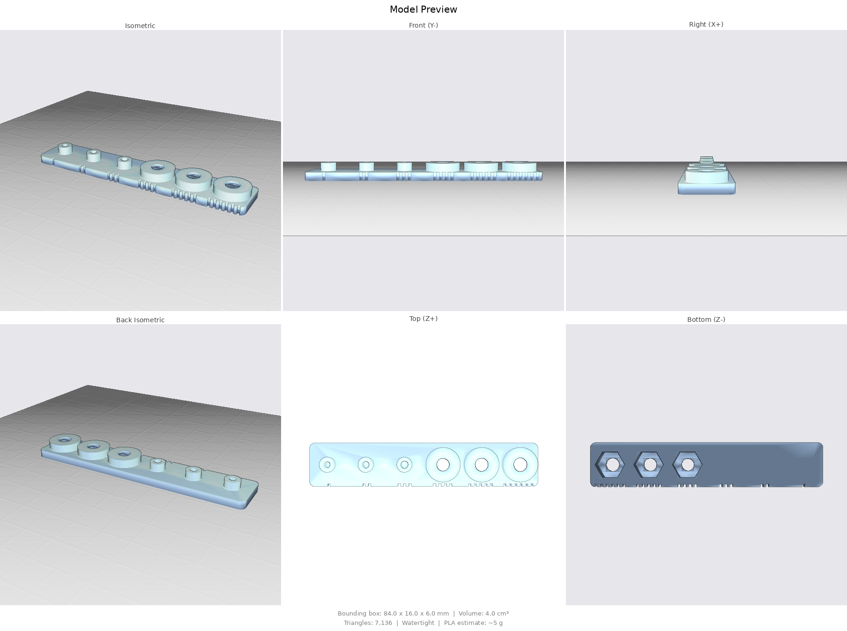
cad/out/hole_ladder_preview.png
