aarochu/DirecSun/cad/out/battery_cap_a.stl

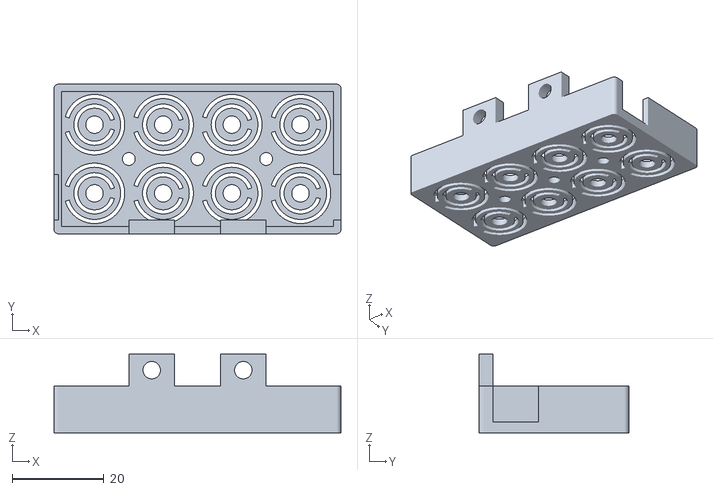
[picture p5: CAD file, 2026-10-10]
cad/out/battery_cap_a.stl
62.7 x 32.7 x 17.2
