aarochu/DirecSun/cad/out/hole_ladder.stl

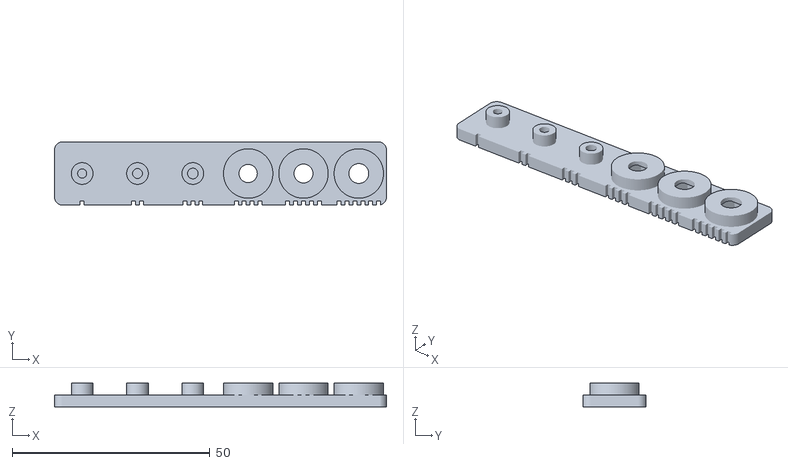
[picture p6: CAD file, 2026-10-10]
cad/out/hole_ladder.stl
84.0 x 16.0 x 6.00
