aarochu/DirecSun/cad/out/bottom_cap.stl

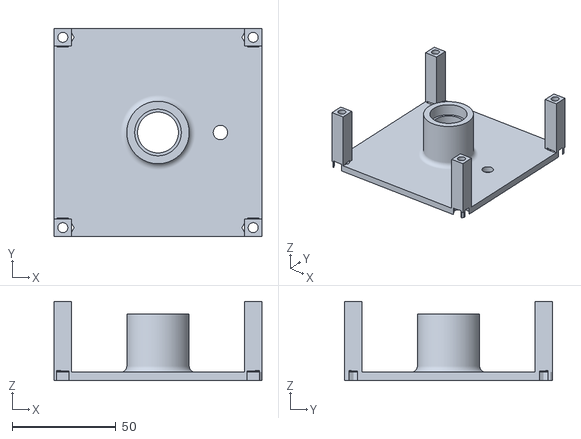
[picture p7: CAD file, 2026-10-10]
cad/out/bottom_cap.stl
100.0 x 100.0 x 38.0
