aarochu/DirecSun/cad/out/power_deck.stl

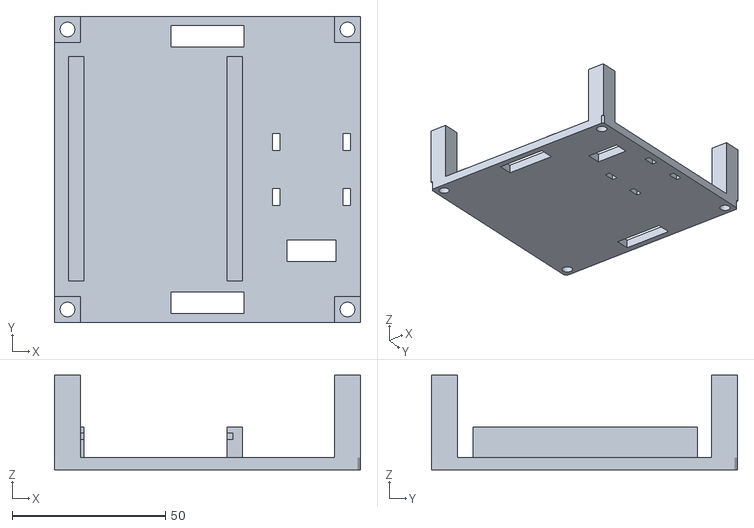
[picture p8: CAD file, 2026-10-10]
cad/out/power_deck.stl
100.0 x 100.0 x 31.0
