aarochu/DirecSun/cad/out/top_deck.stl

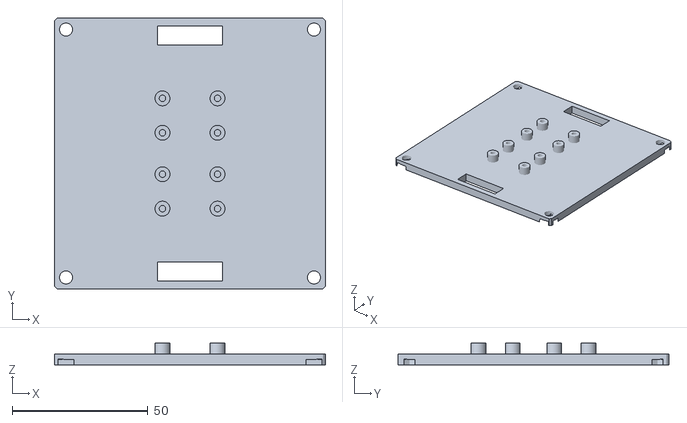
[picture p9: CAD file, 2026-10-10]
cad/out/top_deck.stl
100.0 x 100.0 x 8.00
