aarochu/DirecSun/cad/out/base_hub.stl

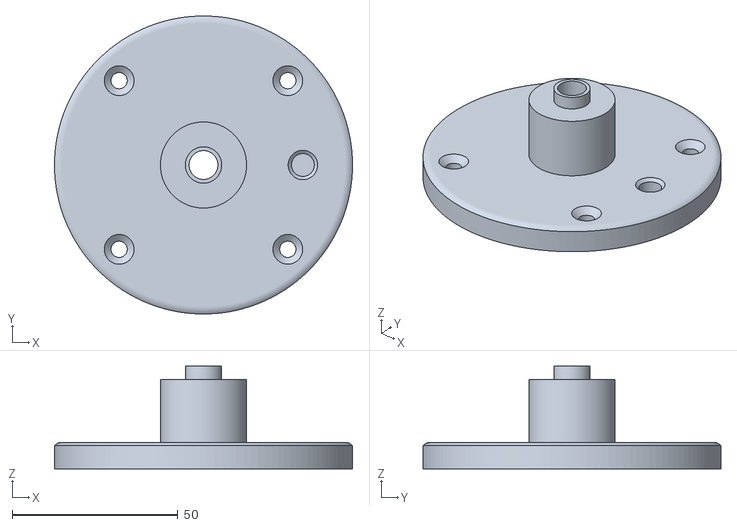
[picture p10: CAD file, 2026-10-10]
cad/out/base_hub.stl
90.0 x 90.0 x 31.0
