aarochu/DirecSun/cad/out/hole_gauge.stl

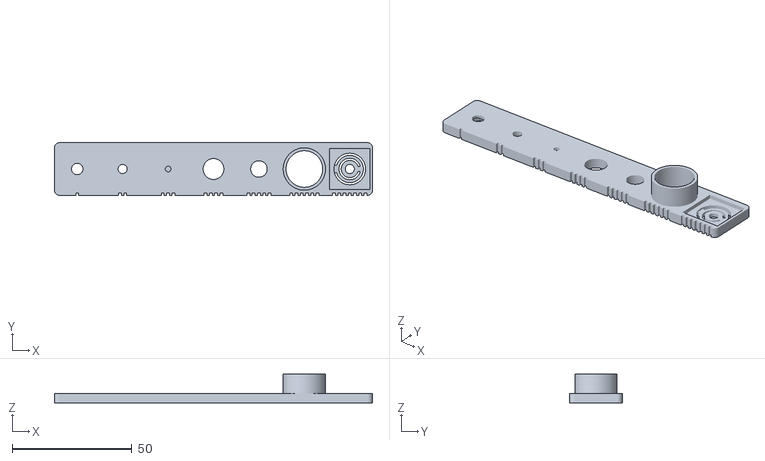
[picture p11: CAD file, 2026-10-10]
cad/out/hole_gauge.stl
133.0 x 22.0 x 12.0
