aarochu/DirecSun/testresults/2026-10-11-battery-divider/6-v67-build-10v-0405.txt

Script started on 2026-10-11 04:05:22-04:00 [COMMAND="timeout 12 /tmp/claude-1000/-home-jazoe-projects-DirecSun/1be52b11-7750-47ce-bd9a-3561643d28b1/scratchpad/wt/prop-R3.7/tools/idf.sh -B build-flight -D SDKCONFIG=build-flight/sdkconfig -p /dev/ttyACM0 monitor --no-reset" <not executed on terminal>]
Executing action: monitor
Running idf_monitor in directory /tmp/claude-1000/-home-jazoe-projects-DirecSun/1be52b11-7750-47ce-bd9a-3561643d28b1/scratchpad/wt/prop-R3.7/firmware
Executing "/home/jazoe/.espressif/tools/python/v6.0/venv/bin/python /home/jazoe/.espressif/v6.0/esp-idf/tools/idf_monitor.py -p /dev/ttyACM0 -b 115200 --toolchain-prefix xtensa-esp32s3-elf- --target esp32s3 --revision 0 /tmp/claude-1000/-home-jazoe-projects-DirecSun/1be52b11-7750-47ce-bd9a-3561643d28b1/scratchpad/wt/prop-R3.7/firmware/build-flight/direcsun.elf /tmp/claude-1000/-home-jazoe-projects-DirecSun/1be52b11-7750-47ce-bd9a-3561643d28b1/scratchpad/wt/prop-R3.7/firmware/build-flight/bootloader/bootloader.elf --no-reset -m '/home/jazoe/.espressif/tools/python/v6.0/venv/bin/python' '/home/jazoe/.espressif/v6.0/esp-idf/tools/idf.py' '-B' 'build-flight' '-D' 'SDKCONFIG=build-flight/sdkconfig' '-p' '/dev/ttyACM0'"...
--- esp-idf-monitor 1.9.0 on /dev/ttyACM0 115200
--- Quit: Ctrl+] | Menu: Ctrl+T | Help: Ctrl+T followed by Ctrl+H
I (20637) status: s 19 ticks 500 missed 0 (total 0) loop_us_max I (123665) status: s 122 ticks 500 missed 0 (total 0) loop_us_max 756 dev_max_us 1 p99_dev_us 1 dshot sent 61517 dropped 0 imu_invalid 0
I (123666) status: mode SAFE throttle 0 vbat 10.02 rate 0.02 bias -2.09 tilt 2.7 psi 6.1 wheel 0 latched 0x0010 flags 0x00 baro --
I (124677) status: s 123 ticks 500 missed 0 (total 0) loop_us_max 756 dev_max_us 4 p99_dev_us 1 dshot sent 62017 dropped 0 imu_invalid 0
I (124678) status: mode SAFE throttle 0 vbat 10.02 rate -0.04 bias -2.09 tilt 2.7 psi 6.1 wheel 0 latched 0x0010 flags 0x00 baro --
I (125689) status: s 124 ticks 500 missed 0 (total 0) loop_us_max 756 dev_max_us 5 p99_dev_us 1 dshot sent 62517 dropped 0 imu_invalid 0
I (125692) status: mode SAFE throttle 0 vbat 10.02 rate 0.02 bias -2.09 tilt 2.8 psi 6.1 wheel 0 latched 0x0010 flags 0x00 baro --
I (126451) status: s 125 ticks 500 missed 0 (total 0) loop_us_max 756 dev_max_us 4 p99_dev_us 2 dshot sent 63017 dropped 0 imu_invalid 0
I (126452) status: mode SAFE throttle 0 vbat 10.02 rate -0.04 bias -2.09 tilt 2.7 psi 6.1 wheel 0 latched 0x0010 flags 0x00 baro --
I (127463) status: s 126 ticks 500 missed 0 (total 0) loop_us_max 756 dev_max_us 1 p99_dev_us 1 dshot sent 63517 dropped 0 imu_invalid 0
I (127464) status: mode SAFE throttle 0 vbat 10.02 rate -0.04 bias -2.09 tilt 2.6 psi 6.1 wheel 0 latched 0x0010 flags 0x00 baro --
I (128475) status: s 127 ticks 500 missed 0 (total 0) loop_us_max 757 dev_max_us 2 p99_dev_us 1 dshot sent 64017 dropped 0 imu_invalid 0
I (128476) status: mode SAFE throttle 0 vbat 10.02 rate -0.04 bias -2.09 tilt 2.7 psi 6.1 wheel 0 latched 0x0010 flags 0x00 baro --
I (129487) status: s 128 ticks 500 missed 0 (total 0) loop_us_max 756 dev_max_us 5 p99_dev_us 1 dshot sent 64517 dropped 0 imu_invalid 0
I (129488) status: mode SAFE throttle 0 vbat 10.01 rate -0.04 bias -2.09 tilt 2.7 psi 6.1 wheel 0 latched 0x0010 flags 0x00 baro --
I (130499) status: s 129 ticks 500 missed 0 (total 0) loop_us_max 757 dev_max_us 1 p99_dev_us 1 dshot sent 65017 dropped 0 imu_invalid 0
I (130500) status: mode SAFE throttle 0 vbat 10.02 rate 0.02 bias -2.09 tilt 2.6 psi 6.1 wheel 0 latched 0x0010 flags 0x00 baro --
I (131511) status: s 130 ticks 500 missed 0 (total 0) loop_us_max 756 dev_max_us 4 p99_dev_us 1 dshot sent 65517 dropped 0 imu_invalid 0
I (131512) status: mode SAFE throttle 0 vbat 10.02 rate -0.04 bias -2.09 tilt 2.7 psi 6.1 wheel 0 latched 0x0010 flags 0x00 baro --
I (132523) status: s 131 ticks 500 missed 0 (total 0) loop_us_max 757 dev_max_us 1 p99_dev_us 1 dshot sent 66017 dropped 0 imu_invalid 0
I (132524) status: mode SAFE throttle 0 vbat 10.02 rate 0.02 bias -2.09 tilt 2.7 psi 6.1 wheel 0 latched 0x0010 flags 0x00 baro --
I (133535) status: s 132 ticks 500 missed 0 (total 0) loop_us_max 756 dev_max_us 1 p99_dev_us 1 dshot sent 66517 dropped 0 imu_invalid 0
I (133536) status: mode SAFE throttle 0 vbat 10.03 rate -0.04 bias -2.09 tilt 2.6 psi 6.1 wheel 0 latched 0x0010 flags 0x00 baro --

Script done on 2026-10-11 04:05:34-04:00 [COMMAND_EXIT_CODE="124"]
