aarochu/DirecSun/testresults/2026-10-11-esc-dshot150-spins/6-v68-build-boot-0403.txt

40513.242177 I (111) esp_image: segment 1: paddr=000328d8 vaddr=3fca9700 size efuse_ESP-ROM:esp32s3-20210327
40513.242435 Build:Mar 27 2021
40513.243213 rst:0x15 (USB_UART_CHIP_RESET),boot:0x8 (SPI_FAST_FLASH_BOOT)
40513.243642 Saved PC:0x40048836
40513.245035 SPIWP:0xee
40513.245223 mode:DIO, clock div:1
40513.247200 load:0x3fce2820,len:0x14f0
40513.250818 load:0x403c8700,len:0xda0
40513.253145 load:0x403cb700,len:0x2f58
40513.260586 entry 0x403c8908
40513.265928 I (24) boot: ESP-IDF v6.0 2nd stage bootloader
40513.265928 I (24) boot: compile time Oct 10 2026 23:41:56
40513.266182 I (25) boot: Multicore bootloader
40513.268885 I (25) boot: chip revision: v0.2
40513.272354 I (27) boot: efuse block revision: v1.4
40513.276177 I (31) boot.esp32s3: Boot SPI Speed : 80MHz
40513.279967 I (35) boot.esp32s3: SPI Mode       : DIO
40513.283758 I (39) boot.esp32s3: SPI Flash Size : 8MB
40513.288281 I (42) boot: Enabling RNG early entropy source...
40513.290835 I (47) boot: Partition Table:
40513.297277 I (49) boot: ## Label            Usage          Type ST Offset   Length
40513.303705 I (56) boot:  0 nvs              WiFi data        01 02 00009000 00006000
40513.310369 I (62) boot:  1 phy_init         RF data          01 01 0000f000 00001000
40513.316665 I (69) boot:  2 factory          factory app      00 00 00010000 00177000
40513.319874 I (75) boot: End of partition table
40513.327390 I (79) esp_image: segment 0: paddr=00010020 vaddr=3c0a0020 size=228b0h (141488) map
40513.353175 I (111) esp_image: segment 1: paddr=000328d8 vaddr=3fca9700 size=087cch ( 34764) load
40513.360683 I (119) esp_image: segment 2: paddr=0003b0ac vaddr=40378000 size=04f6ch ( 20332) load
40513.365679 I (124) esp_image: segment 3: paddr=00040020 vaddr=42000020 size=9e914h (649492) map
40513.482578 I (241) esp_image: segment 4: paddr=000de93c vaddr=4037cf6c size=1c700h (116480) load
40513.508434 I (267) esp_image: segment 5: paddr=000fb044 vaddr=50000004 size=00024h (    36) load
40513.523054 I (281) boot: Loaded app from partition at offset 0x10000
40513.523054 I (281) boot: Disabling RNG early entropy source...
40513.533319 I (292) cpu_start: Multicore app
40513.541769 I (300) cpu_start: GPIO 44 and 43 are used as console UART I/O pins
40513.542370 I (301) cpu_start: Pro cpu start user code
40513.543760 I (301) cpu_start: cpu freq: 240000000 Hz
40513.547586 I (302) app_init: Application information:
40513.551617 I (306) app_init: Project name:     direcsun
40513.555492 I (310) app_init: App version:      65f9c11
40513.560532 I (314) app_init: Compile time:     Oct 10 2026 23:41:34
40513.565198 I (319) app_init: ELF file SHA256:  54941720c...
40513.568503 I (324) app_init: ESP-IDF:          v6.0
40513.572372 I (327) efuse_init: Min chip rev:     v0.0
40513.576389 I (331) efuse_init: Max chip rev:     v0.99
40513.580175 I (335) efuse_init: Chip rev:         v0.2
40513.586419 I (339) heap_init: Initializing. RAM available for dynamic allocation:
40513.591635 I (345) heap_init: At 3FCBD9E0 len 0002BD30 (175 KiB): RAM
40513.596806 I (350) heap_init: At 3FCE9710 len 00005724 (21 KiB): RAM
40513.602169 I (355) heap_init: At 3FCF0000 len 00008000 (32 KiB): DRAM
40513.607358 I (361) heap_init: At 600FE000 len 00001FE8 (7 KiB): RTCRAM
40513.610739 I (367) spi_flash: detected chip: gd
40513.613656 I (369) spi_flash: flash io: dio
40513.619766 I (373) sleep_gpio: Configure to isolate all GPIO pins in sleep state
40513.626214 I (378) sleep_gpio: Enable automatic switching of GPIO sleep configuration
40513.629590 I (385) main_task: Started on CPU0
40513.633087 I (388) main_task: Calling app_main()
40513.652534 I (410) dshot: GPIO7 DShot300: bit 133 ticks, '1' high 100, '0' high 50 at 40000000 Hz
40513.652583 I (411) direcsun: DirecSun flight firmware
40513.656983 I (411) direcsun: firmware 65f9c11, ESP-IDF v6.0
40513.662946 I (415) direcsun: target esp32s3, chip ESP32-S3 rev v0.2, 2 cores
40513.667627 I (421) direcsun: flash 8MB configured, 8MB detected
40513.672138 I (426) direcsun: reset reason: USB peripheral (11)
40513.678190 I (430) direcsun: DShot300 zeros on GPIO7 from 45191 us after boot
40513.683194 W (436) direcsun: parameters reset to defaults (missing)
40513.689133 I (441) shared: command queue 16 x 44 B, outbound queue 16 x 96 B
40513.698272 I (447) i2cdev: [Port 0] First initialization. Configuring bus with SDA=5, SCL=6 (Pullups SCL:0 SDA:0)
40513.705565 I (457) i2cdev: [Port 0] Successfully installed I2C master bus (Handle: 0x3fcea6f4).
40513.713736 I (464) i2cdev: [Port 0] Shared bus handle retrieved: 0x3fcea6f4 (SDA=5, SCL=6, ref_count=0)
40513.722530 I (472) i2c_bus: bus on port 0: SDA GPIO5, SCL GPIO6, 400000 Hz per device; probe of 0x68: ESP_OK
40513.731287 I (481) i2cdev: [0x68 at 0] Device added successfully (Device Handle: 0x3fceac7c, Speed: 400000 Hz).
40513.738335 I (492) imu: MPU-6050 WHO_AM_I 0x68; DLPF 4, +-2000 deg/s, +-4 g, 400000 Hz SCL
40513.742493 I (496) direcsun: IMU: ESP_OK (WHO_AM_I 0x68)
40513.745817 I (501) QMC5883P: QMC5883P Chip ID: 0x80
40513.755965 I (514) QMC5883P: QMC5883P initialized successfully
40513.757558 I (515) mag: QMC5883P chip ID 0x80; 8 G, normal mode, ODR 200 Hz, 400000 Hz SCL
40513.762200 I (516) direcsun: magnetometer: ESP_OK (chip ID 0x80)
40513.771452 I (520) i2cdev: [0x77 at 0] Device added successfully (Device Handle: 0x3fcead44, Speed: 400000 Hz).
40513.780218 W (529) i2cdev: [0x77 at 0] I2C op failed (Try 0, Handle 0x3fcead44): 264 (ESP_ERR_INVALID_RESPONSE).
40513.819473 W (578) i2cdev: [0x77 at 0] Retrying operation...
40513.821850 W (578) i2cdev: [0x77 at 0] I2C op failed (Try 1, Handle 0x3fcead44): 264 (ESP_ERR_INVALID_RESPONSE).
40513.901473 W (660) i2cdev: [0x77 at 0] Retrying operation...
40513.905127 W (660) i2cdev: [0x77 at 0] I2C op failed (Try 2, Handle 0x3fcead44): 264 (ESP_ERR_INVALID_RESPONSE).
40514.063450 W (822) i2cdev: [0x77 at 0] Retrying operation...
40514.065768 W (822) i2cdev: [0x77 at 0] I2C op failed (Try 3, Handle 0x3fcead44): 264 (ESP_ERR_INVALID_RESPONSE).
40514.075298 E (824) i2cdev: [0x77 at 0] I2C operation failed after 4 retries. Last error: 264 (ESP_ERR_INVALID_RESPONSE)
40514.078052 E (834) bmp280: Sensor not found
40514.082671 E (836) baro: chip ID 0x08 at 0x77, expected 0x58
40514.088784 I (841) direcsun: barometer: ESP_ERR_INVALID_RESPONSE (chip ID 0x08)
40514.096094 I (847) adc_inputs: sun A: GPIO1 = ADC1 channel 0, 12 dB, curve-fitting calibration
40514.103484 I (854) adc_inputs: sun B: GPIO2 = ADC1 channel 1, 12 dB, curve-fitting calibration
40514.111211 I (862) adc_inputs: battery: GPIO8 = ADC1 channel 7, 12 dB, curve-fitting calibration
40514.654126 I (1411) direcsun: gyro z bias seeded at -2.094 deg/s from 271 still samples (range 0.122); accel reference 0.870 g (norm 0.866 to 0.875)
40514.662452 I (1412) direcsun: boot window done: 501 DShot frames sent, battery 0.01 V over 28 readings
40514.668441 I (1421) hall: A1104 edge capture on GPIO9, falling edge, ring of 8
40514.671625 I (1422) pp: pp rom version: e7ae62f
40514.681634 I (1427) control: control task on core 1; it takes the DShot output over from the zero sender at its first tick
40514.685826 I (1430) net80211: net80211 rom version: e7ae62f
40514.692103 I (1445) wifi:wifi driver task: 3fcc7194, prio:23, stack:6656, core=0
40514.701866 I (1460) wifi:wifi firmware version: 44738b4
40514.701866 I (1460) wifi:wifi certification version: v7.0
40514.703669 I (1460) wifi:config NVS flash: enabled
40514.707781 I (1462) wifi:config nano formatting: disabled
40514.712908 I (1466) wifi:Init data frame dynamic rx buffer num: 32
40514.717186 I (1471) wifi:Init static rx mgmt buffer num: 5
40514.721597 I (1475) wifi:Init management short buffer num: 32
40514.725579 I (1480) wifi:Init dynamic tx buffer num: 32
40514.729597 I (1484) wifi:Init static tx FG buffer num: 2
40514.733860 I (1488) wifi:Init static rx buffer size: 1600
40514.737722 I (1492) wifi:Init static rx buffer num: 10
40514.741715 I (1496) wifi:Init dynamic rx buffer num: 32
40514.744529 I (1500) wifi_init: rx ba win: 6
40514.747618 I (1503) wifi_init: accept mbox: 6
40514.750924 I (1506) wifi_init: tcpip mbox: 32
40514.753760 I (1509) wifi_init: udp mbox: 6
40514.756622 I (1512) wifi_init: tcp mbox: 6
40514.759944 I (1515) wifi_init: tcp tx win: 5760
40514.763210 I (1518) wifi_init: tcp rx win: 5760
40514.766308 I (1521) wifi_init: tcp mss: 1440
40514.769998 I (1524) wifi_init: WiFi IRAM OP enabled
40514.773933 I (1528) wifi_init: WiFi RX IRAM OP enabled
40514.782628 W (1532) wifi:Password length matches WPA2 standards, authmode threshold changes from OPEN to WPA2
40514.788380 I (1541) phy_init: phy_version 711,97bcf0a2,Aug 25 2025,19:04:10
40514.828695 I (1586) wifi:mode : sta (e0:72:a1:fc:49:5c)
40514.828695 I (1587) wifi:enable tsf
40514.829447 I (1588) wifi:Set ps type: 0, coexist: 0
40514.829447 
40514.831333 I (1588) wifi: joining "<bench-network>"
40514.835309 I (1591) wifi: mDNS hostname direcsun.local
40514.842958 I (1596) wifi:new:<8,0>, old:<1,0>, ap:<255,255>, sta:<8,0>, prof:6, snd_ch_cfg:0x0
40514.846167 I (1601) wifi:state: init -> auth (0xb0)
40514.852199 I (1607) ws: WebSocket server on port 80 at /ws (up to 3 clients)
40514.855953 I (1610) main_task: Returned from app_main()
40514.907219 I (1665) wifi:state: auth -> assoc (0x0)
40514.940949 I (1699) wifi:state: assoc -> run (0x10)
40515.075767 I (1833) wifi:connected with <bench-network>, aid = 4, channel 8, BW20, bssid = <bssid>
40515.077846 I (1834) wifi:security: WPA2-PSK, phy: bgn, rssi: -30
40515.080673 I (1838) wifi:pm start, type: 0
40515.080673 
40515.088862 I (1839) wifi:dp: 1, bi: 102400, li: 3, scale listen interval from 307200 us to 307200 us
40515.097250 I (1847) wifi:set rx beacon pti, rx_bcn_pti: 0, bcn_timeout: 25000, mt_pti: 0, mt_time: 10000
40515.116286 I (1874) wifi:<ba-add>idx:0 (ifx:0, <bssid>), tid:7, ssn:2, winSize:64
40515.119025 I (1874) wifi:<ba-add>idx:1 (ifx:0, <bssid>), tid:0, ssn:2, winSize:64
40515.124744 I (1878) wifi:AP's beacon interval = 102400 us, DTIM period = 1
40515.913113 I (2671) status: s 1 ticks 501 missed 0 (total 0) loop_us_max 1542 dev_max_us 62 p99_dev_us 14 dshot sent 1017 dropped 0 imu_invalid 0
40515.924557 I (2671) status: mode SAFE throttle 0 vbat 0.02 rate 0.02 bias -2.09 tilt 2.8 psi -0.0 wheel 0 latched 0x0010 flags 0x00 baro --
40516.108216 I (2866) esp_netif_handlers: sta ip: 192.168.8.224, mask: 255.255.255.0, gw: 192.168.8.1
40516.109045 I (2866) wifi: connected, address 192.168.8.224
40516.115397 I (2867) wifi: WebSocket: ws://direcsun.local/ws  or  ws://192.168.8.224/ws
40516.924842 I (3683) status: s 2 ticks 500 missed 0 (total 0) loop_us_max 756 dev_max_us 1 p99_dev_us 1 dshot sent 1517 dropped 0 imu_invalid 0
40516.936278 I (3683) status: mode SAFE throttle 0 vbat 0.02 rate -0.04 bias -2.09 tilt 2.7 psi 0.0 wheel 0 latched 0x0010 flags 0x00 baro --
40517.686911 I (4445) status: s 3 ticks 500 missed 0 (total 0) loop_us_max 756 dev_max_us 4 p99_dev_us 1 dshot sent 2017 dropped 0 imu_invalid 0
40517.698440 I (4445) status: mode SAFE throttle 0 vbat 0.03 rate -0.04 bias -2.09 tilt 2.9 psi 0.0 wheel 0 latched 0x0010 flags 0x00 baro --
40518.698954 I (5457) status: s 4 ticks 500 missed 0 (total 0) loop_us_max 755 dev_max_us 4 p99_dev_us 1 dshot sent 2517 dropped 0 imu_invalid 0
40518.710507 I (5457) status: mode SAFE throttle 0 vbat 0.02 rate 0.02 bias -2.09 tilt 2.8 psi 0.0 wheel 0 latched 0x0010 flags 0x00 baro --
40519.711116 I (6469) status: s 5 ticks 500 missed 0 (total 0) loop_us_max 755 dev_max_us 1 p99_dev_us 1 dshot sent 3017 dropped 0 imu_invalid 0
40519.722612 I (6469) status: mode SAFE throttle 0 vbat 0.02 rate 0.02 bias -2.09 tilt 2.8 psi 0.0 wheel 0 latched 0x0010 flags 0x00 baro --
40520.722795 I (7481) status: s 6 ticks 500 missed 0 (total 0) loop_us_max 755 dev_max_us 2 p99_dev_us 1 dshot sent 3517 dropped 0 imu_invalid 0
40520.734342 I (7481) status: mode SAFE throttle 0 vbat 0.02 rate 0.02 bias -2.09 tilt 2.8 psi 0.0 wheel 0 latched 0x0010 flags 0x00 baro --
40521.734955 I (8493) status: s 7 ticks 500 missed 0 (total 0) loop_us_max 754 dev_max_us 2 p99_dev_us 1 dshot sent 4017 dropped 0 imu_invalid 0
40521.746520 I (8493) status: mode SAFE throttle 0 vbat 0.03 rate 0.02 bias -2.09 tilt 2.8 psi 0.0 wheel 0 latched 0x0010 flags 0x00 baro --
40522.746805 I (9505) status: s 8 ticks 500 missed 0 (total 0) loop_us_max 755 dev_max_us 4 p99_dev_us 1 dshot sent 4517 dropped 0 imu_invalid 0
40522.758636 I (9505) status: mode SAFE throttle 0 vbat 0.03 rate 0.02 bias -2.09 tilt 2.8 psi 0.0 wheel 0 latched 0x0010 flags 0x00 baro --
40523.758848 I (10517) status: s 9 ticks 500 missed 0 (total 0) loop_us_max 756 dev_max_us 4 p99_dev_us 1 dshot sent 5017 dropped 0 imu_invalid 0
40523.770359 I (10517) status: mode SAFE throttle 0 vbat 0.02 rate -0.04 bias -2.09 tilt 2.7 psi 0.0 wheel 0 latched 0x0010 flags 0x00 baro --
40524.770870 I (11529) status: s 10 ticks 500 missed 0 (total 0) loop_us_max 757 dev_max_us 1 p99_dev_us 1 dshot sent 5517 dropped 0 imu_invalid 0
40524.783073 I (11529) status: mode SAFE throttle 0 vbat 0.02 rate -0.04 bias -2.09 tilt 2.8 psi -0.0 wheel 0 latched 0x0010 flags 0x00 baro --
40525.782896 I (12541) status: s 11 ticks 500 missed 0 (total 0) loop_us_max 755 dev_max_us 1 p99_dev_us 1 dshot sent 6017 dropped 0 imu_invalid 0
40525.794438 I (12541) status: mode SAFE throttle 0 vbat 0.03 rate -0.04 bias -2.10 tilt 2.9 psi -0.0 wheel 0 latched 0x0010 flags 0x00 baro --
40526.794902 I (13553) status: s 12 ticks 500 missed 0 (total 0) loop_us_max 756 dev_max_us 5 p99_dev_us 3 dshot sent 6517 dropped 0 imu_invalid 0
40526.806536 I (13553) status: mode SAFE throttle 0 vbat 0.02 rate 0.02 bias -2.10 tilt 2.8 psi -0.0 wheel 0 latched 0x0010 flags 0x00 baro --
40527.806887 I (14565) status: s 13 ticks 500 missed 0 (total 0) loop_us_max 755 dev_max_us 5 p99_dev_us 1 dshot sent 7017 dropped 0 imu_invalid 0
40527.818494 I (14565) status: mode SAFE throttle 0 vbat 0.02 rate -0.04 bias -2.10 tilt 2.8 psi -0.0 wheel 0 latched 0x0010 flags 0x00 baro --
40528.818842 I (15577) status: s 14 ticks 500 missed 0 (total 0) loop_us_max 755 dev_max_us 4 p99_dev_us 2 dshot sent 7517 dropped 0 imu_invalid 0
40528.830382 I (15577) status: mode SAFE throttle 0 vbat 0.02 rate 0.02 bias -2.09 tilt 2.8 psi -0.0 wheel 0 latched 0x0010 flags 0x00 baro --
40529.830988 I (16589) status: s 15 ticks 500 missed 0 (total 0) loop_us_max 755 dev_max_us 4 p99_dev_us 2 dshot sent 8017 dropped 0 imu_invalid 0
40529.843171 I (16589) status: mode SAFE throttle 0 vbat 0.02 rate 0.02 bias -2.09 tilt 2.7 psi -0.0 wheel 0 latched 0x0010 flags 0x00 baro --
40530.842872 I (17601) status: s 16 ticks 500 missed 0 (total 0) loop_us_max 755 dev_max_us 4 p99_dev_us 1 dshot sent 8517 dropped 0 imu_invalid 0
40530.854390 I (17601) status: mode SAFE throttle 0 vbat 0.02 rate 0.02 bias -2.09 tilt 3.0 psi -0.0 wheel 0 latched 0x0010 flags 0x00 baro --
40531.859298 I (18613) status: s 17 ticks 500 missed 0 (total 0) loop_us_max 755 dev_max_us 4 p99_dev_us 2 dshot sent 9017 dropped 0 imu_invalid 0
40531.867187 I (18613) status: mode SAFE throttle 0 vbat 0.03 rate 0.02 bias -2.09 tilt 2.8 psi -0.0 wheel 0 latched 0x0010 flags 0x00 baro --
40532.867067 I (19625) status: s 18 ticks 500 missed 0 (total 0) loop_us_max 755 dev_max_us 3 p99_dev_us 1 dshot sent 9517 dropped 0 imu_invalid 0
40532.878453 I (19625) status: mode SAFE throttle 0 vbat 0.03 rate 0.02 bias -2.09 tilt 2.8 psi 0.0 wheel 0 latched 0x0010 flags 0x00 baro --
