aarochu/DirecSun/testresults/2026-10-11-ui-recorder-linux/2-headed-summary.txt

== turn: recorder exit 0 / checker exit 0
== stop: recorder exit 0 / checker exit 1
== estop: recorder exit 0 / checker exit 0
== watch: recorder exit 0 / checker exit 0
