aarochu/DirecSun/cad/out/washer_stack_test_preview.png

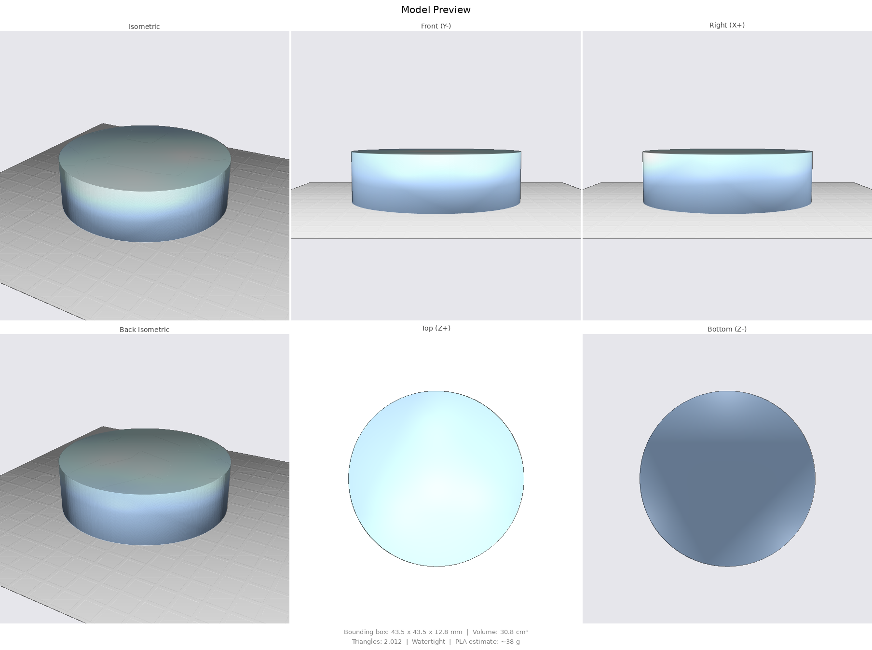
cad/out/washer_stack_test_preview.png
