aarochu/DirecSun/changes/1-foundation/R1.4-firmware-skeleton.md

# R1.4: Firmware skeleton (ESP-IDF v6.0, C++17, XIAO ESP32-S3)

**Status:** done
**Files:** `firmware/CMakeLists.txt`, `firmware/sdkconfig.defaults`, `firmware/sdkconfig.defaults.local.example`, `firmware/dependencies.lock`, `firmware/.gitignore`, `firmware/main/{CMakeLists.txt,idf_component.yml,app_main.cpp}`, `firmware/components/direcsun_core/CMakeLists.txt`, `firmware/components/direcsun_drivers/{CMakeLists.txt,include/,src/}`, `firmware/components/direcsun_comms/{CMakeLists.txt,include/,src/}`, `firmware/components/qmc5883p/` (vendored), `tools/idf.sh`, `.vscode/extensions.json`

## Spec

**Problem:** There is no buildable firmware project. The FD's toolchain (Arduino-ESP32, PlatformIO) was replaced by plain ESP-IDF to match the validated sensor libraries and the drone environment. Those libraries have never been built together, or with C++ application code. Integration failures should surface now, not in the middle of Set 3.

**Approach:**
- **Project.** Project name `direcsun`, with `idf.py` run from `firmware/`. `firmware/CMakeLists.txt` forces C++17 (`idf_build_set_property(CXX_COMPILE_OPTIONS "-std=gnu++17" APPEND)`) and sets `PROJECT_VER` from `git describe --always --dirty`. It sets `SDKCONFIG_DEFAULTS` to `sdkconfig.defaults`, plus `sdkconfig.defaults.local` when that file exists.
- **`sdkconfig.defaults`.** Port the drone's annotated file section by section: target esp32s3, 240 MHz, `-O2` (perf), `FREERTOS_HZ=1000`, the core-affinity pins, both watchdogs on, run-time stats, the I2C ISR in IRAM, and the i2cdev new driver. Add:
  - `CONFIG_HTTPD_WS_SUPPORT=y` and `CONFIG_ESP_WIFI_STA_DISCONNECT_PM_ENABLE=n`, both from the verified DirecSun1.
  - 8 MB flash, which is what the XIAO ESP32-S3 has, with `CONFIG_PARTITION_TABLE_SINGLE_APP_LARGE=y` so Wi-Fi, httpd, and mDNS fit in the app partition. The validated examples ran with the 2 MB default.
  - C++ exceptions and RTTI off. These are IDF defaults, pinned explicitly.
  - Primary console on UART0 with the secondary on USB-Serial-JTAG, which is how the validated examples reached USB.

  Every line carries a one-line reason, like the drone file. The system task watchdog stays at 5 s; the 100 ms control-task watchdog belongs to Set 3.
- **`sdkconfig.defaults.local.example`.** Documents the Wi-Fi keys that Set 3's Kconfig menu will read. In this feature it is only an example file.
- **`main/idf_component.yml`.** Requires `idf: ">=6.0,<6.1"`, `esp-idf-lib/mpu6050: "^2.1.9"` and `esp-idf-lib/bmp280: "^1.0.7"` (the validated versions), plus `espressif/mdns` and `espressif/cjson`, because v6.0 bundles neither. Versions are resolved by the component manager and recorded in `dependencies.lock`, which is committed for reproducible builds on Aaron's machine and in CI.
- **`components/qmc5883p/`.** A verbatim copy of `~/projects/qmc5883p-espidf-example/components/duruofu__qmc5883p`, the validated copy (identical to the drone's apart from YAML quoting), with its license kept. No edits here. The 400 kHz and sensitivity fixes land in Set 3 as documented local patches.
- **Components.** Each gets a CMakeLists and an empty `include/` and `src/`:
  - `direcsun_core`: pure C++17 with no `REQUIRES`. R1.5 fills it.
  - `direcsun_drivers`: `REQUIRES direcsun_core mpu6050 bmp280 qmc5883p`.
  - `direcsun_comms`: `REQUIRES direcsun_core esp_http_server esp_wifi mdns cjson`.

  `main` requires all three, so every managed component is compiled and linked now rather than found broken later.
- **`app_main.cpp`.** `extern "C" void app_main()` logs the project version, IDF version, chip model and revision, flash size, and "DirecSun skeleton". No tasks yet.
- **`tools/idf.sh`.** Sources the EIM activation script for v6.0 (`~/.espressif/tools/activate_idf_v6.0.sh`, overridable with `DIRECSUN_IDF_ACTIVATE`), changes into `firmware/`, and runs `idf.py "$@"`.
- **`firmware/.gitignore`.** `build/`, `sdkconfig`, `sdkconfig.old`, `managed_components/`, `sdkconfig.defaults.local`.
- **`.vscode/extensions.json`.** Recommends `espressif.esp-idf-extension`. Machine-specific settings stay untracked.

## Tests
- [x] Clean build from a fresh clone: `tools/idf.sh set-target esp32s3 && tools/idf.sh build` exits 0. The log shows target esp32s3 and the resolved versions of mpu6050, bmp280, i2cdev, mdns, and cjson.
- [x] The libraries really compiled: `firmware/build/compile_commands.json` has entries for `mpu6050.c`, `bmp280.c`, `i2cdev.c`, and `qmc5883p.c`. A green build without them would only prove that an unlinked `main` compiles.
- [x] C++17 is in effect: the compile commands for `app_main.cpp` contain `-std=gnu++17`, with no later `-std=` flag overriding it.
- [x] The defaults took effect: the generated `firmware/sdkconfig` contains `CONFIG_IDF_TARGET="esp32s3"`, `CONFIG_FREERTOS_HZ=1000`, `CONFIG_HTTPD_WS_SUPPORT=y`, `CONFIG_ESPTOOLPY_FLASHSIZE_8MB=y`, and `CONFIG_PARTITION_TABLE_SINGLE_APP_LARGE=y`.
- [x] Hardware, with the rig on USB. Nothing spins here: there is no DShot code, and the ESC may be unpowered. First, `esptool --port <port> flash-id` reports 8 MB, which validates the flash assumption before it is trusted. Then `tools/idf.sh -p <port> flash monitor` boots and prints the banner with the version, `esp32s3`, and `8MB`, with no panic or watchdog reset over 60 s.

## Notes / log
- 2026-10-10: Built on `feat/set1/R1.4-firmware-skeleton` (ec0938a vendors qmc5883p verbatim, `diff -r` empty; 6222658 adds the skeleton). ESP-IDF 6.0.0. Resolved: mpu6050 2.1.9, bmp280 1.0.7, i2cdev 2.1.1 (pinned `==2.1.1`, the validated version; 2.1.2 exists), esp_idf_lib_helpers 1.4.0, mdns 1.14.0, cjson 1.7.19~1. App 157,344 B of a 1,536,000 B partition; that number excludes Wi-Fi code, which the linker strips until something calls it.
  - Clean build from a fresh clone of the pushed branch, run from `/tmp` and `/`: exit 0, "Set Target to: esp32s3", 7 dependencies listed.
  - compile_commands.json has entries for mpu6050.c, bmp280.c, i2cdev.c, qmc5883p.c (plus cjson and 48 mdns files).
  - C++17: IDF emits `-std=gnu++26` and the project's `-std=gnu++17` follows it in all 25 C++ entries. Independent check: preprocessing app_main.cpp with the real command gives `__cplusplus 201703L`; with the project flag removed it gives `202400L`.
  - Defaults: all 36 default lines compared against the generated sdkconfig; 35 match. `FREERTOS_USE_TICKLESS_IDLE` is hidden without power management, as expected. Positive controls: a made-up symbol and DirecSun1's misspelled symbol are both reported missing.
  - Hardware boot: BLOCKED, no Espressif device on USB (`lsusb` lists 7 devices, none 303a). Stays `[ ]` until the XIAO is connected.
  - Deviations, all accepted:
    - Registry dependencies are declared in `direcsun_drivers/idf_component.yml` and `direcsun_comms/idf_component.yml` (component-scoped, per the esp-idf-components skill); `main/idf_component.yml` pins only `idf`.
    - `REQUIRES` uses the managed names (`esp-idf-lib__mpu6050`, `espressif__mdns`, ...), and i2cdev is listed explicitly because Set 3 calls it directly.
    - DirecSun1's `ESP_WIFI_STA_DISCONNECT_PM_ENABLE` was a misspelling that IDF ignored silently. The real symbol `ESP_WIFI_STA_DISCONNECTED_PM_ENABLE` is used, so DirecSun1 actually ran with that power-management option still on.
    - `FREERTOS_USE_STATS_FORMATTING_FUNCTIONS=y` was added; in v6.0, `VTASKLIST_INCLUDE_COREID` depends on it, and without it the drone repo's setting is silently dropped too.
    - `tools/idf.sh` exports the output of the EIM script's `-e` mode instead of sourcing the script, because the script exits when sourced from another script.
  - Unrelated, in the drone repo (not fixed here): the same dropped `VTASKLIST_INCLUDE_COREID` setting, and `.vscode/c_cpp_properties.json` points at the riscv32 compiler for an esp32s3 target.
- 2026-10-10: Hardware boot test run on the XIAO ESP32-S3. The first board plugged in was an ESP32-C3 (QFN32 rev v0.4, single core, 4 MB, MAC 80:f1:b2:63:46:2c): the flash-ID instrument check caught it before anything was flashed, and Julian swapped boards.
  - The S3: `esptool flash-id` reports ESP32-S3 (QFN56) rev v0.2, dual core, 8 MB PSRAM, "Detected flash size: 8MB", MAC e0:72:a1:fc:49:5c.
  - `tools/idf.sh -p /dev/ttyACM0 flash`: all three images written and hash-verified.
  - 70 s of `idf.py monitor` (run under `script` for a pty) shows the banner: "DirecSun skeleton", "firmware e079631, ESP-IDF v6.0", "target esp32s3, chip ESP32-S3 rev v0.2, 2 cores", "flash 8MB configured, 8MB detected".
  - No panic, abort, watchdog, backtrace, or error lines appeared. There was exactly one `rst:` line, the initial `USB_UART_CHIP_RESET`; the same grep would have shown a second one if the board had rebooted.
- 2026-10-10: Merged `feat/set1/R1.4-firmware-skeleton` into `feat/set1-foundation`; the README conflict was additive and both sides were kept.
