aarochu/DirecSun/(commit log)

2026-10-10 docs(changes): scaffold set 1 foundation specs
    Add changes/CONTEXT.md with the project invariants decided in the
    grilling session, and the Set 1 index plus seven feature specs
    (scaffold and skills, docs import, CAD import, firmware skeleton,
    host test harness, protocol/link/console, CI). Planning only; no code.
    Claude-Session: https://claude.ai/code/session_01TufiGRAcDsJTos6wanR3xp
2026-10-10 feat(repo): scaffold monorepo with pinned agent skills and spec-gate hooks
    Add spec-driven-dev, cad-skill, and awesome-esp-ai as pinned https
    submodules, symlink the esp-idf skills into .agents/skills, and link
    .claude to .agents so Claude Code and other agents share one tree. Wire
    the spec-gate pre-merge and stop hooks, and add README, AGENTS.md, and
    CLAUDE.md (which imports AGENTS.md).
    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
2026-10-10 docs: rename to DirecSun, repo paths, plain fixes, no em dashes
    - PocketADCS -> DirecSun (title notes the former name); sizing.py
    docstring likewise (it is not printed, so the output is unchanged).
    - ~/projects/pocketadcs and ~/Downloads paths -> repository paths.
    - Plain fixes: V-3 (example vbat 10.1 V), V-18 (920 KV typo), V-19
    (0.84 kg box), "d4.7" heading, broken CELL_L markup, A-13 register
    row now records the 50.17 mm measurement, missing pick-list tab noted.
    - Em dashes in the firmware design replaced with plain punctuation.
    Each edit is logged in the documents' validation logs in a later commit.
    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
2026-10-10 docs: platform and network sections for ESP-IDF v6.0, C++17, mDNS
    TD 6.1, 7, 8, 11, 12 and FD 6, 7.2, 8.1, 10, 15.1, 15.2, 16, 17, 18,
    19.3, 20.2, 21, 22, 24 rewritten for the 2026-10-10 decisions:
    ESP-IDF v6.0 with C++17 replaces Arduino-ESP32/PlatformIO;
    esp_http_server WebSocket on port 81 and cJSON from espressif/cjson;
    validated sensor drivers on one i2cdev-owned bus at 400 kHz; Wi-Fi
    station with DHCP and mDNS (direcsun.local), static address and SoftAP
    as menuconfig options; 2.4 GHz only; CAD pipeline through
    tools/build-cad.sh and cad/out; repo git flow; Aaron's UI through
    ground/link; firmware layout under firmware/components. New
    assumptions A-23 (shared bus) and A-24 (WebSocket on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
2026-10-10 chore(firmware): vendor duruofu/qmc5883p 0.1.0 verbatim
    Copied unchanged from ~/projects/qmc5883p-espidf-example/components/
    duruofu__qmc5883p, the copy validated on the XIAO ESP32-S3 (identical to
    drone-flight-software's apart from YAML quoting). License kept. The
    400 kHz and sensitivity fixes land in Set 3 as documented local patches.
    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
2026-10-10 feat(firmware): ESP-IDF v6.0 C++17 skeleton for the XIAO ESP32-S3
    Add the direcsun project under firmware/ with three components
    (direcsun_core, direcsun_drivers, direcsun_comms) that pull in every
    sensor and networking library now, so integration breaks surface in
    Set 1 rather than Set 3. app_main prints a boot banner only.
    - sdkconfig.defaults ported from drone-flight-software, each line checked
    against the v6.0 Kconfig and the generated sdkconfig. Adds 8 MB flash,
    the large single-app partition, the WebSocket option, and the stats
    formatting option that VTASKLIST_INCLUDE_COREID needs in v6.0.
    DirecSun1's ESP_WIFI_STA_DISCONNECT_PM_ENABLE was a misspelling that IDF
    ignored; the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
2026-10-10 docs: write the approved firmware-design amendments into the TD body
    Owner approval 2026-10-10. Additions: disarm, 0.5 s Ready dwell,
    magnetometer and sun guards, respin replacing the automatic momentum
    dump (V-2), Hall-silent interlock (V-11), controlling-client heartbeat
    (V-15). Corrections: K_omega 0.0129 and the T-3 pass band (V-1),
    magnetometer axis map (V-4), aliasing at the electrical frequency
    (V-5), fast and median wheel-speed estimates (V-7), gyro at 2000 deg/s
    (V-9), ack echoes the command seq (V-14), ramp limits acceleration not
    final rate (V-20), DShot150 default (V-21). The FD state diagram now
    lets disarm leave every active mode, as its own command table says.
    Claude-Session: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
2026-10-10 docs: add MANUAL mode to the TD and the firmware design
    Owner decision 2026-10-10: one wire mode MANUAL entered from READY with
    an input of throttle, wheel, or rate, each refused until its loop is
    built. Setpoints arrive as cmd "manual" with exactly one of throttle,
    wheel_rpm, or rate_dps, clamped, controlling client only, up to 20 Hz,
    each counting as heartbeat. Staleness: after 250 ms without setpoints
    the rate input falls to zero while throttle and wheel hold; the 1 s
    heartbeat still applies. New tlm field manual_input, flag MANUAL_STALE,
    params manual_throttle_min/max, host test HT-11, glossary entry. The
    mode count is now eight. FD 13.4 no longer says the TD conflicts.
    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
2026-10-10 docs: rebuild the three lost TD diagrams in Mermaid
    The Claude Doc export left [embedded content] placeholders. Rebuilt:
    system architecture (Section 2, adapted from FD 4.1, any 2.4 GHz AP),
    mode state machine (Section 6.6, nine states including MANUAL, one
    fault path from the ARMED composite), and build roadmap (Section 11,
    5 phases and 4 gates, G2 highlighted). The lost stack render now
    points at cad/out/assembly_view.stl.
    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
2026-10-10 docs: validation-log entries for the import, flywheel note, docs index
    TD 12.4 gains a "Repository import, 2026-10-10" subsection (I-1 to
    I-16) and FD 23.1 gains rows V-22 to V-29, covering every edit made on
    import. TD 4.5 records the owner's printed-flywheel decision and hands
    its follow-up to Set 2. Leftover toolchain names outside the logs are
    moved into them, the Wi-Fi drop mitigation no longer assumes the
    OM5P-AC, and docs/README.md indexes the documents and the precedence
    rule.
    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
2026-10-10 docs: name each TD interlock by its wire event name
    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
2026-10-10 feat(firmware): host test harness, wrap_pi, and core purity check
    Add a plain-CMake host build of direcsun_core with vendored doctest
    2.4.11 (MIT), ASan and UBSan, and -Werror. tools/host-test.sh fails if
    the doctest summary is missing or reports zero test cases, and its
    --selftest mode builds a deliberately failing test that must fail the
    run. tools/check-core-purity.sh rejects ESP-IDF, FreeRTOS, and driver
    includes in the core, with a --selftest that injects one.
    The first core function is direcsun::wrap_pi, onto (-pi, pi] per FD
    section 11.3. The core component now uses SRC_DIRS so the firmware and
    host builds compile the same files.
    Claude-Session: https://claude.ai/code/session_01Tufi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
2026-10-10 feat(cad): import CadQuery sources and the cad/out build pipeline
    Copy the 18 CadQuery scripts and cad/README.md from pocketadcs. Geometry
    is unchanged; only the stack.py docstring and the README commands and
    name move to DirecSun.
    tools/bootstrap-venv.sh builds a Python 3.12 .venv from exact pins (the
    venv that built the parts, plus jsonschema and websockets for the
    protocol tools). tools/build-cad.sh is the only producer of cad/out: it
    runs each part through the cad-skill runner with --preview --strict,
    runs the assembly collision check with its positive controls, and
    records source hashes in cad/out/manifest.json. A preview is replaced
    only when its STL bytes change, because renders diff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
2026-10-10 build(cad): generate cad/out with tools/build-cad.sh
    18 STLs (16 part scripts, battery_holder_cap writes two caps, plus the
    assembly viewing model), 18 six-view previews, and the manifest. All
    parts watertight; assembly: no overlaps among 47 solids, 6/6 positive
    controls detected.
    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
2026-10-10 docs: regenerate sizing output and align Section 3 figures
    docs/sizing_output.txt predated the Oct 10 03:32 stack.py change.
    Re-run from the current CAD: rate per 1000 rpm 356 -> 355 (baseline),
    151 -> 150 (fallback); 3 A wheel acceleration 4861 -> 4860 and
    11604 -> 11603 rpm/s. TD Section 3 figures that already disagreed with
    the old output now match: 357 -> 355 deg/s, 253 -> 254 g, Iz 4.50e-4
    -> 4.54e-4, 844 -> 845 g, 1.59 -> 1.58 and 1.26 -> 1.25 rev/s,
    578 -> 576 deg/s2, 639 -> 640 and 1510 -> 1513 rpm. I_b stays 1.03e-3,
    so K_omega is unchanged. Logged as TD 12.4 I-17; FD 23.2 TD-value
    column follows.
    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
2026-10-10 feat(protocol): wire schema v1 with fixtures and checker
    protocol/schema-v1.json encodes firmware-design section 15 as amended
    in R1.2, including MANUAL, manual setpoints, respin, and bench tlm
    fields, with additionalProperties false throughout. It also encodes the
    safety contracts a field type can carry: tlm throttle is 0 or 48..2047,
    manual_input is set exactly in MANUAL, and set_params cannot carry
    omega_cap_rpm.
    tools/check-schema.py checks 25 valid and 24 invalid fixtures. Each
    invalid fixture differs from a named valid base in exactly one key, so
    it isolates one rule. It also validates JSON-lines captures and fails
    on an empty one.
    Claude-Session: https://claude.ai/code/session_01Tuf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
2026-10-10 feat(ground): DirecSunLink client module with tests
    A dependency-free ES module implementing the client side of schema v1:
    5 Hz ping with RTT stats, command promises settled by the ack with the
    same seq (REFUSED, TIMEOUT after 1 s, CLOSED), an estop that is never
    queued and throws when the link is not open, manual setpoints spaced
    at least 50 ms apart with the latest value winning, and no automatic
    reconnect.
    13 node --test cases run on a fake WebSocket and clock.
    tools/check-link.sh also validates every message the tests send
    against the schema.
    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
2026-10-10 feat(tools): mock box speaking schema v1
    A protocol stub of the box for the console and Aaron's UI: 50 Hz tlm,
    acks, mode events, pong, the FD 13.1 mode machine with MANUAL and its
    250 ms staleness rule, the controlling-client rule, and the 1 s
    heartbeat. Every outbound message is validated against the schema and
    inbound ones are refused with the reason. It listens on 8081 because
    port 81 needs root. --selftest validates every outbound kind.
    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
2026-10-10 feat(ground): bench console on the link module
    DirecSun1's device-link page, kept in its visual design, rewired to
    DirecSunLink and schema v1. It shows mode, heading, rate, wheel,
    battery, loop time, RTT, and flags, and logs frames. Arm asks to
    confirm the lock pin first; e-stop is a button and the space bar.
    Telemetry is marked stale when the link closes. The endpoint defaults
    to ws://direcsun.local:81/ and is remembered in localStorage. The
    README gets a Ground link and console quickstart.
    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
2026-10-10 fix(console): separate the frame count from the verbose toggle label
    The frames header read "every tlm and ping 9", which made the logged-row
    count look like part of the checkbox option. It now reads "9 logged"
    followed by "show every tlm and ping".
    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
2026-10-10 ci: run every repository check and the firmware build on GitHub Actions
    tools/check-all.sh runs core purity, host tests, schema fixtures, link
    tests, the mock box selftest, and CAD staleness, each with its selftest,
    in a fixed order and with full per-step logs; --firmware adds the build.
    The ci workflow runs it on feature pushes and PRs to main, and builds
    the firmware in the espressif/idf:v6.0 container.
    Also renames bootstrap-venv.sh's base-interpreter variable to
    DIRECSUN_BASE_PYTHON: DIRECSUN_PYTHON already means the interpreter with
    the tool packages in check-link.sh and check-schema.py.
    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
2026-10-10 Add DirecSun frontend: landing page and simulated ground station
    React 18 + TypeScript + Vite app in frontend/ with two routes:
    - / : landing page with OrbitSpace hero, system diagram, hardware
    breakdown (10 collapsible rows), control-loop explainer and a static
    ground-station preview
    - /ground-station : browser ground station driven by a local simulator
    (rotate left/right 90°, hold 1.0 s, automatic return, stop/reset),
    with heading dial, telemetry readouts, heading-history chart and a
    read-only WebSocket device-link panel
    Dependencies are pinned in package-lock.json; React stays on 18.3.1
    because orbit-space does not support React 19. The build also writes
    dist/ground-station/i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
2026-10-10 docs(context): frontend is the main UI; wire sign and endpoint follow it
    Decided by Julian on 2026-10-10 after Aaron's frontend PR (#1): the UI
    leads the wire interface, the backend matches it. Wire values are
    clockwise positive (firmware converts at the protocol boundary), the
    WebSocket is port 80 at /ws, the UI owns the operator client, and
    ground/link and ground/console become engineering bench tools.
    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
2026-10-10 docs(changes): add R1.8 (match the UI's wire contract) and R1.9 (frontend CI)
    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
2026-10-10 ci: check the main UI (frontend/) in CI and in check-all
    Adds a frontend job (Node 22, npm ci, typecheck, unit tests, e2e in the
    runner's Google Chrome, with a step that fails loudly if Chrome is
    missing) and a matching opt-in tools/check-all.sh --frontend. README and
    AGENTS.md now name frontend/ as the main UI that the backend matches,
    and describe ground/link and ground/console as bench tools.
    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
2026-10-10 feat(protocol): match the main UI's wire contract (clockwise sign, port 80 /ws)
    The main UI (frontend/, PR #1) draws positive heading clockwise and
    connects to ws://<box>/ws, and the backend matches it. The schema now
    describes every quantity about the spin axis as clockwise positive and
    the endpoint as port 80 at /ws; protocol/README.md records the change
    as a v1 correction and the additive-stays-v1 versioning rule. The link
    module's default URL, its tests, the console's labels and hints, and
    the README follow. The mock box serves only /ws (404 elsewhere), and
    its selftest starts the real server to prove both.
    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
2026-10-10 docs: wire frame, endpoint, and the main UI contract
    FD section 2.3 keeps the internal counter-clockwise frame and adds the
    clockwise wire frame, converted only in the protocol layer. Sections 3,
    4.2, 15.1 to 15.3, 19.3, 21, and 24 follow the main UI; section 17 is
    rewritten as the integration contract with frontend/, from its source
    at 622150a. TD sections 6.1, 7.2, 7.3, and 7.4 match. New log rows:
    FD 23.1 U-1 to U-4, TD 12.4 U-1 to U-3.
    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
2026-10-10 fix(console): header shows port 80 /ws; no negative zero in readouts
    Found in the R1.8 screenshots: the header still read PORT 81, and a box
    rate rounding to zero from below printed -0.0.
    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
2026-10-10 docs(changes): R1.4 hardware boot test passes on the XIAO ESP32-S3
    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
2026-10-10 frontend: printed flywheel copy; full-width URL field on phones
    Flywheel copy (issue #6): the wheel is now a printed PETG flywheel with
    seven steel washers sealed inside and the two Hall magnets in the wheel,
    not a clamped washer stack with nothing printed spinning.
    - Hardware row 07: name, function, connection, control role and design
    note updated; speeds stay labeled as targets, now pending the
    rotating-part safety analysis.
    - Hardware row 06: the Hall switch reads magnets in the flywheel, not on
    the motor bell.
    - System diagram: "2212 MOTOR + PRINTED FLYWHEEL", and its caption.
    URL field (issue #6): below 480 px the Connect button stacks under the
    field, so ws://127.0.0.1:8081/ws n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
2026-10-10 frontend: show device flags, wheel reference and throttle band
    Issue #6: with device telemetry, the ground station now shows what the
    box reports beyond heading and rate.
    - flags: listed under the device mode. Latched interlocks (ESTOP,
    HEARTBEAT_LOST, OVERSPEED and the rest) are red and prefixed LATCHED;
    warnings such as MOMENTUM_NEAR_LIMIT, MANUAL_STALE and HALL_BYPASS are
    amber; MOMENTUM_OK is muted. Unknown future flag names show as
    warnings, so additive v1 flags appear without a UI change.
    - wheel_ref_rpm: shown under the wheel speed as "REF n RPM".
    - throttle_band [lo, hi]: an optional field (Set 3, R3.7); a THROTTLE
    BAND row appears only while the box sends it.
    Simulation r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
2026-10-10 frontend: control the box from the ground station
    Issue #6, the main item. When the Device link is receiving telemetry,
    the ground station now operates the box, replacing the simulation
    controls (the simulator stays untouched and resets as before).
    - Arm and disarm. Arm opens a confirmation ("the lock pin is in, or
    someone is holding the box still"); nothing is sent until it is
    checked and confirmed (FD 13.3 and V-13: firmware cannot sense the pin).
    - E-stop button, plus the space bar while the box is armed. It is sent
    at once, never queued, and throws visibly when the link is not open.
    Space is ignored in text fields, and its key-up is swallowed while
    armed so a focused button is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
2026-10-10 docs: WORKSTREAMS.md, the Julian/Aaron split both agents coordinate from
    Julian owns printing, measuring, bench electronics, firmware, and the
    wire contract (protocol/, the mock box, the link module). Aaron owns
    frontend/ and integration testing, and requests contract changes as
    "Contract:" issues. AGENTS.md now has every agent read WORKSTREAMS.md
    first; CONTEXT.md's ownership table and TD 11.5 (I-19) follow.
    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
2026-10-10 frontend: rotatable CAD views in the hardware section
    Replaces the black "image not provided" placeholders in the ten hardware
    rows with views built from the project's own CAD (cad/assembly.py).
    - Each row opens a 3D view of the full stack with that row's part
    highlighted: the part bright with amber edges, the printed part that
    carries it grey, everything else a faint ghost. Drag to rotate, Ctrl
    or Cmd + scroll or pinch to zoom, arrow keys and +/- from the keyboard,
    a reset button, and a "part only" toggle. Plain scrolling still scrolls
    the page, and a vertical swipe on touch still scrolls.
    - A 1600x1200 poster per row shows instantly, covers the load, and is
    the fallback withou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
2026-10-10 frontend: scroll-driven landing page; previous app moves to frontend/draft
    The new landing page (vanilla TypeScript, three.js, anime.js) replaces the
    React app in frontend/. One fixed CAD view is driven by a scroll timeline
    through five chapters: hero, system, hardware, control loop, ground station.
    - System section: an interactive flowchart of every electronic part and how
    they connect, from docs/technical-design.md Sections 2 and 5. Power,
    sensing and control paths can be shown on their own; hovering or tapping
    a part explains it and lights the same part on the model.
    - Hero: the previous site's orbit-space star field, ported to plain three.js
    (same texture, count and camera behav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
2026-10-10 testresults: add I2C scan log for ESP32-C3 bench controller
    Records the MPU-6050, QMC5883P and BMP280 address scans (each sensor
    detected alone, three devices detected with a split chain, full
    three-board chain failed) and indexes it in testresults/README.md.
2026-10-10 testresults: S3 bench sessions from 2026-10-10
    Nine session logs in the testresults/ format, each with its raw serial
    captures beside it:
    - first boot of the firmware skeleton (R1.4)
    - three-sensor I2C bus and 73 s soak (R3.2)
    - battery and sun ADC with nothing wired (invalid; kept as a record)
    - control task first run (failed) and after the fixes (697 s)
    - control-stall watchdog, timed with a raw serial reader
    - BMP280 dropout, standalone bus scan, and rewire
    - same-binary A/B: the barometer read stretches the IMU read
    - A1104 Hall edge count by hand (rpm half deferred to the flywheel)
    The README index is updated from these logs only; Aaron's entries are
    kept as they were.
    Claude-Session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
2026-10-11 frontend: run the demo offline from one command (#24)
    Issue #18, the offline half. A venue may have no internet, and the box's
    own Wi-Fi has none, so the demo needs a path that does not depend on the
    hosted site.
    - npm run demo builds the landing page and the app (installing first if
    needed) and serves frontend/dist on http://localhost:8080, with the
    same /draft/* rewrite as vercel.json. A missing file is a 404 instead
    of the app page (a missing script no longer comes back as HTML).
    demo:serve reuses the last build, --host 0.0.0.0 serves other devices,
    and demo:check builds and probes the served pages.
    - Plain http, so the browser allows ws:// to the box (the https copy on
    Verce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
2026-10-11 frontend/draft: one shared WebGL context for the hardware 3D views (#27)
    Follow-ups from the #15 review (issue #21).
    - One shared WebGL renderer draws every view and copies the frame into
    that view's own canvas. Opening a row no longer creates a context,
    relinks shaders or re-uploads geometry, and closed views no longer
    leave contexts behind: 12 open/close cycles used to create 12
    contexts, and now create 1. renderer.debug.checkShaderErrors is off in
    production, so shader compiles no longer block on the program log.
    - An open row keeps its view while you scroll, instead of remounting it
    each time it crosses the viewport.
    - The 3D view's focus ring is visible (the frame clipped i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
2026-10-11 frontend: board detail, fuzzy hero title; ground station CAD view and sensor panel (#23)
    * frontend: board detail, fuzzy hero title; ground station CAD view and sensor panel
    Landing page (frontend/):
    - Electronics detail on the CAD model, website only (src/detail.ts). The
    XIAO ESP32-S3, the three STEMMA QT sensor boards and the 2212 motor are
    rebuilt inside their CAD boxes (shield can, USB-C, pads, connectors,
    chips, bell); the ESC gets its leads and both perfboards get a hole grid
    and their parts (buck module, fuse, divider, 470 uF cap, terminals,
    1N5817, resistors). Detail fades, highlights and explodes with its part.
    The CAD and GLB are unchanged.
    - Hero title drawn as fuzzy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
2026-10-11 frontend: name the operator client for what it is (#28)
    Issue #20. The operator client (arm, e-stop, heartbeat) lived in a folder
    called draft, and "Overview" in it led to the old landing page.
    - frontend/draft is now frontend/ground-station, served at
    /ground-station/. The ground station is the app's root route; the
    previous landing page, which still owns the rotatable hardware 3D
    views, moves to /overview (/ground-station/overview in production).
    - "Overview" in the ground station goes to the site root, the scroll-
    driven landing page, not to the old landing.
    - The old /draft URLs redirect (Vercel redirects and the demo server):
    /draft/ground-station to /ground-station/, anythin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
2026-10-11 frontend: landing page follow-ups and tests (#19) (#29)
    * frontend: landing page follow-ups from the #16 review, and tests
    Issue #19.
    - The flowchart no longer clips on phones and tablets. Below 900 px the
    System chapter shows the same parts as a list: each part with what it
    connects to ("-> XIAO ESP32-S3 (I2C)"), tap to pin it, the same chips,
    the same highlighting on the model. The SVG chart stays at 900 px and
    up. The list version is built from the same node and edge data.
    - "System" in the header and "See how it works" now land on a fully
    drawn chart (+1300 ms, not +300), and each wire's arrowhead appears
    as its line finishes instead of floating first.
    - Text over the 3D mo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
2026-10-11 frontend: add pitch and demo runbook (#31)
2026-10-11 Polish landing accessibility and reduced motion
    Approved by Julian; CI green. Makes visible content the main landmark, keeps narrow ticker text contained, and respects reduced motion.
2026-10-11 Complete landing flowchart power and network details
    Approved by Julian; CI green. Adds the documented power and 2.4 GHz network paths.
2026-10-11 Add concise component bullets to the landing page
    Approved by Julian. Resolved the landing test conflict with current main, retained both tests, and passed local and CI suites.
2026-10-11 frontend: sharpen landing hero copy (#38)
    * frontend: sharpen landing hero copy
    * frontend: describe judge turn as pause, not heading hold
2026-10-11 Keep detailed hardware visuals in close-ups and Ground Station (#45)
    * Add concise hardware component bullets to landing page
    * Share detailed CubeSat visuals across hardware views
    * frontend: resolve shared Three.js from ground station install
2026-10-11 ground station: mode menu next to the rotate buttons (#53)
    A Mode dropdown to the right of Rotate right sends cmd mode for READY, HOLD, MANUAL
    (rate, throttle or wheel input), DETUMBLE and SUN_POINT. It is enabled only while this
    client controls the box in a mode that allows a change and no turn is running. HOLD and
    MANUAL are disabled outside READY, as the firmware refuses them there; DETUMBLE and
    SUN_POINT are sent so the box answers its own refusal, which the result line shows.
    The rotate buttons shrink to fit the third control.
2026-10-11 frontend: set the top bars in IBM Plex Mono (#54)
    The landing page header (name, System, Hardware, Control, Ground Station), the same
    header in the ground station's landing page, and the ground station's own header now
    use the IBM Plex Mono already loaded by the app, buttons and wordmark included.
2026-10-11 ground station: manual setpoint slider that streams in MANUAL (#55)
    * ground station: mode menu next to the rotate buttons
    * ground station: manual setpoint slider that streams while the box is in MANUAL
    In MANUAL the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
2026-10-11 ground station: one mode registry, ready for the firmware's DETUMBLE and SUN_POINT (#56)
    * ground station: manual setpoint slider that streams while the box is in M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
2026-10-11 ground station: cover all eight modes per TD 6.6 and 7.4 (#58)
    In MANUAL the page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
2026-10-11 ground station: collapse Sensor readings when a device connects (#71)
    With a box connected at 1440x900 the expanded Sensor readings panel squeezed the
    Telemetry readouts down to their header. The panel now collapses once when device
    telemetry starts; the operator can open it again and it stays open until the next
    connection. Without a device the saved preference still applies.
2026-10-11 ground station: space bar e-stops from any focus while armed (FD 17, V-63) (#60)
    The space bar used to be ignored while a text, number or range input had focus, so
    with the URL field or a slider focused the e-stop key silently did nothing. FD section
    17 (finding V-63) requires the bench console's rule: while armed, Space sends e-stop
    wherever focus is, and no field or button can take the key instead.
2026-10-11 ground station: record every telemetry frame to CSV (#65) (#68)
    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
2026-10-11 Bound ground-station telemetry display lag under slow rendering (#82)
    * frontend: harden hardware operator flow
    * frontend: show wheel-loop readiness before turns
    * frontend: address operator hardening review
    * fix(ui): coalesce ground-station telemetry rendering
    * fix(ui): redraw at once when turn readiness changes
    With #46 merged in, its test "disables Rotate and explains an
    unavailable wheel loop before a turn" failed: the box's wheel reference
    rising above 0 (the wheel loop coming up, which is when turns are
    accepted) changed no mode, flag or arm guard, so the redraw waited for
    the next coalesced frame and Rotate stayed disabled. Turn readiness now
    flushes immediately, like the othe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
2026-10-11 ground station: show notices, motor command, torque and box drop counters (#69)
    SUN_POINT are sent so the box answers its own refusal, which the result line sh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
2026-10-11 ground station: plots for box rate, wheel speed with its band, and battery (#70)
    SUN_POINT are sent so the box answers its own refusal, which the result line s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
2026-10-11 docs: Aaron may edit the unfinished software while Julian tests hardware (#81)
    Julian approved Aaron to edit the firmware and all other unfinished
    software. WORKSTREAMS.md gets a dated section that says what that
    covers and what stays with Julian: the bench, every motor-capable step,
    CAD geometry and printing, and merging into main. The safety rules and
    the spec-first workflow are unchanged.
    AGENTS.md and changes/CONTEXT.md told UI-side agents never to edit
    protocol/, firmware/ or the mock. They now point to that section, so
    Aaron's agents do not refuse the work.
2026-10-11 testresults: bench night of 2026-10-10 and software checks of 2026-10-11 (#87)
    * testresults: the bench night of 2026-10-10 and the software checks of 2026-10-11
    Bench, written up from the bench session's raw captures and the kernel's
    USB log:
    - control tick with the Wi-Fi radio up, before and after V-62;
    - first Wi-Fi station join;
    - battery divider against the meter, passing on the V-67 build;
    - I2C sensor boot probe across the night's boots;
    - the ESC that spun the motor on a DShot150 zero stream while the box
    was SAFE and never armed, and stayed still on DShot300 (V-68);
    - the first-spin dry run with the ESC unpowered.
    Network names and BSSIDs are scrubbed from the captures.
    Software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
2026-10-11 docs(td): record the Bussmann AGC-10 fuse and its inline holder (#49)
    * docs(td): record the Bussmann AGC-10 fuse and its inline holder
    The 10 A pack fuse is a Bussmann AGC-10 from stock (10 A fast-acting
    glass, 6.3 x 32 mm). Section 5.1 now says where it goes (inline holder
    in the pack + lead, PCB clips on the power perfboard as the fallback),
    why 10 A fits the pack's 2.35 A worst case and a 33 A short, and the
    wire gauge after it. The parts lists move it from to-buy to on-hand and
    add the holder to buy.
    * docs(td): source the AGC-10 ratings to Eaton and qualify the fuse claims
    The ratings now come from Eaton's AGC-10-R page, opened in a browser:
    10 A, 6.4 x 32 mm, 250 Vac and 32 Vdc (se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
2026-10-11 docs(hardware): perfboard build sheet for the carrier, power deck, and battery box
    A single page that opens in a browser, so Aaron and Julian can build
    from the same drawing:
    - The XIAO carrier (50 x 35 mm, cut from a 5 x 7 cm board) and the power
    deck (full 5 x 7 cm, MPM3610 buck at K8 to K11), hole by hole, from
    the component side and mirrored from the solder side.
    - Every wire's solder points, every solder bridge, and the buses.
    - The cables between the decks and the battery box cap wiring
    (cad/README.md), with the 10 A AGC-10 on the + lead.
    - A layout self-check: every wire ends on its own net, no bare wire
    touches another net, and each net is one connected piece.
    Two changes f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
2026-10-11 docs(hardware): mirror the power deck to match the MPM3610 as soldered
    On the bench board the MPM3610's pins read GND, 5V, VIN, EN from left
    to right (K8 to K11), the mirror of what the sheet drew. Every part and
    wire on the power deck is mirrored with it, so connectivity is
    unchanged (checked hole by hole against the previous layout). The hole
    names in the cable table and the battery steps follow.
    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
2026-10-11 docs(hardware): one item per hole, with jumpers, solder traces, and cut lengths
    The sheet drew bare wires on the solder side that ran through the same
    holes as part leads, which is not how the boards are being built. Now
    every hole holds one thing (a lead, a jumper end, or a wire leaving the
    board), solid-core jumpers lie on the component side with their route
    and cut length, solder traces name exactly the pads they join, and every
    wire that leaves a board shows its hole, destination, and cut length.
    The layout check also refuses two things in one hole and a jumper that
    passes over a lead.
    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
